LeshanDaFo/MeatLoaf-Hardware-ClausS/Hardware/README.md

# Meatloaf-Hardware-ClausS — Hardware

This directory contains the hardware designs and production documentation for
the Meatloaf carrier-board revisions published in this repository.

## Directory structure

```text
Hardware/
├── PCB-v1.0/
│   ├── README.md     # Revision-specific compatibility, placement, and GPIO information
│   ├── 3D/           # Complete mechanical STEP assembly
│   ├── Images/       # PCB plots, assembly drawing, and 3D renders
│   ├── KiCad/        # Editable KiCad project, schematics, and PCB layout
│   ├── PDF/          # PDF documentation, including schematic exports
│   └── Production/   # PCB manufacturing and assembly files, including Gerbers and BOMs
├── PCB-v1.1a/
├── PCB-v1.1b/
├── PCB-v1.1c/
│   ├── README.md     # Revision-specific design and validation status
│   ├── 3D/           # Complete mechanical STEP assembly
│   ├── Images/       # Verified KiCad rendering
│   ├── KiCad/        # Editable KiCad project and local dependencies
│   ├── PDF/          # Relevant component documentation
│   └── Production/   # Revision-specific manufacturing export
└── README.md
```

## Published hardware revisions

| Revision | Status | Documentation | Design and production files |
| --- | --- | --- | --- |
| PCB v1.0 | Published | [Compatibility, assembly, and GPIO assignments](PCB-v1.0/README.md) | [KiCad](PCB-v1.0/KiCad/) · [Schematic PDF](PCB-v1.0/PDF/Meatloaf-PCB-v1.0-Schematic.pdf) · [Production](PCB-v1.0/Production/) · [3D](PCB-v1.0/3D/) · [Images](PCB-v1.0/Images/) |
| PCB v1.1a | Discrete IEC input stages | [Design and firmware](PCB-v1.1a/README.md) | [KiCad](PCB-v1.1a/KiCad/) · [3D assembly](PCB-v1.1a/3D/Meatloaf-PCB-v1.1a-Assembly.step) · [Production](PCB-v1.1a/Production/) · [Images](PCB-v1.1a/Images/) |
| PCB v1.1b | 74LVC541A IEC input buffer | [Design, GPIO assignments, and validation status](PCB-v1.1b/README.md) | [KiCad](PCB-v1.1b/KiCad/) · [3D assembly](PCB-v1.1b/3D/Meatloaf-PCB-v1.1b-Assembly.step) · [Production](PCB-v1.1b/Production/) · [Images](PCB-v1.1b/Images/) |
| PCB v1.1c | USB-C power input and plug-in W5500 module | [Design and firmware](PCB-v1.1c/README.md) | [KiCad](PCB-v1.1c/KiCad/) · [3D assembly](PCB-v1.1c/3D/Meatloaf-PCB-v1.1c-Assembly.step) · [Production](PCB-v1.1c/Production/) · [Images](PCB-v1.1c/Images/) |

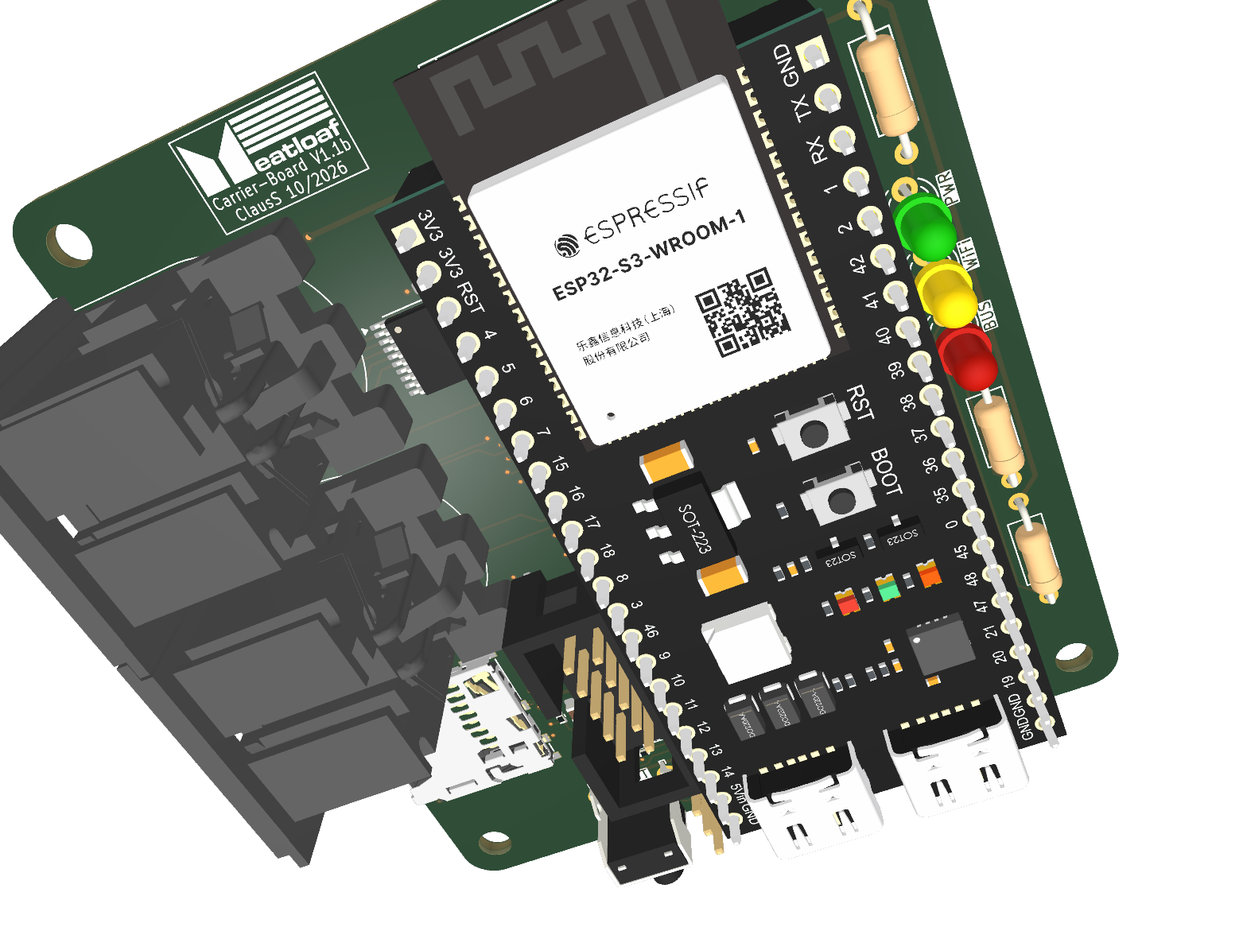
[picture p7: Hardware/PCB-v1.1b/Images/PCB-v1.1b-KiCad-3D.png]
Meatloaf PCB v1.1b development design


*KiCad rendering of the revised PCB v1.1b with the RGB level shifter.*

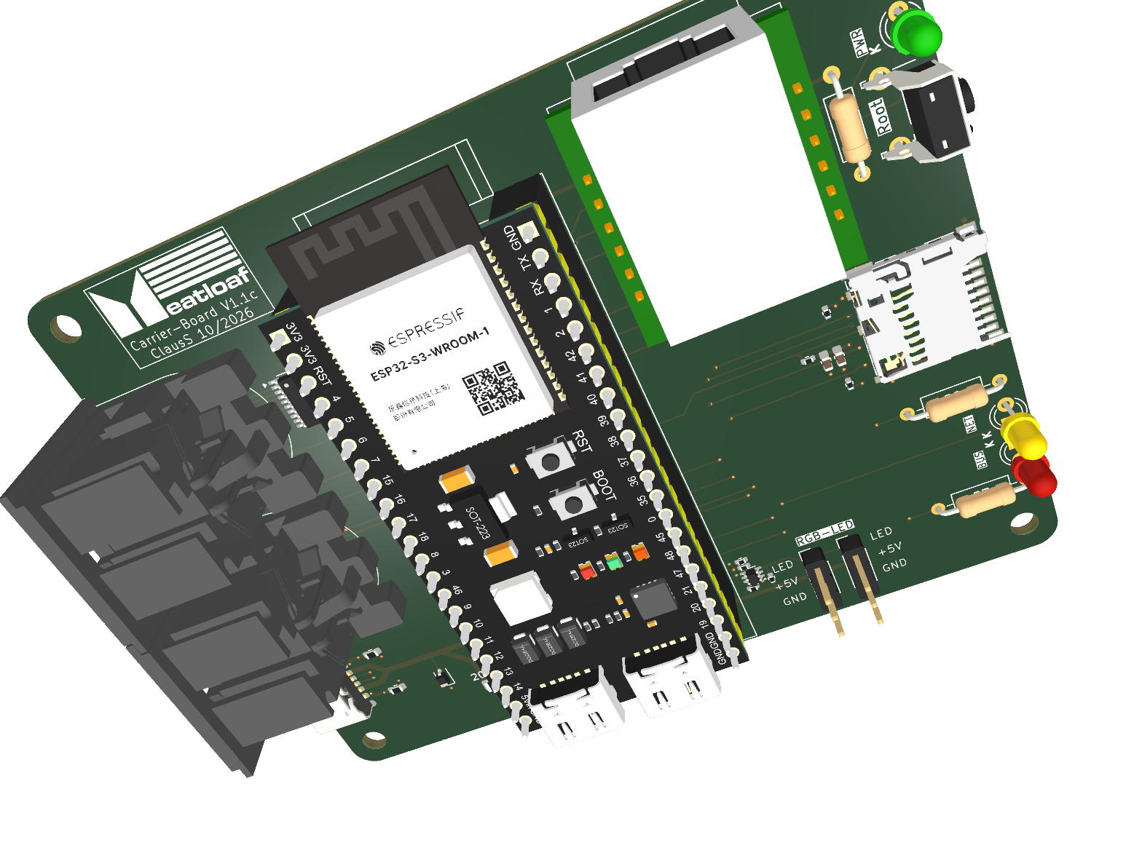
[picture p8: Hardware/PCB-v1.1c/Images/PCB-v1.1c-KiCad-3D-perspective.png]
Meatloaf PCB v1.1c


Each revision directory is self-contained and normally uses the following
structure:

- **`3D/`** contains mechanical STEP exports where provided.
- **`Images/`** contains PCB plots, assembly drawings, and rendered 3D views.
- **`KiCad/`** contains the editable hardware design. Open the project in KiCad to inspect the schematic and PCB layout.
- **`PDF/`** contains exported schematics and component documentation.
- **`Production/`** collects the manufacturing and assembly outputs for the
  revision, including Gerber and drill files, bills of materials (BOMs), and
  other production-related files where provided.

Future PCB revisions can be added as separate directories alongside
`PCB-v1.0/`, `PCB-v1.1a/`, `PCB-v1.1b/`, and `PCB-v1.1c/`. Do not mix documentation, design files, or
manufacturing outputs from different revisions.

## Hardware overview

The project provides custom **ESP32-based Meatloaf carrier boards**. Features,
module layouts, pin assignments, physical connections, and supported firmware
may differ between revisions. Use the documentation inside the selected
revision directory as the authoritative source for compatibility and assembly.

## Before manufacturing or assembly

1. Review the KiCad schematic and PCB layout for the selected revision.
2. Check the files in `Production/` and ensure that the Gerbers, drill files, BOM, and assembly information belong to the same PCB revision.
3. Verify connector orientation, component footprints, supply voltages, and IEC interface wiring.
4. Review any revision-specific notes and confirm the compatibility of the ESP32-S3 module you intend to use.
5. Check the applicable rights and licenses before redistributing third-party libraries, footprints, or 3D models.

## Firmware

Prebuilt firmware packages and installation information are provided separately
in [`Firmware/`](../Firmware/README.md). Select a package that matches the
hardware revision, GPIO configuration, flash capacity, and any other documented
requirements.

## License

The project's original hardware design materials are subject to the terms in [`LICENSE.md`](../LICENSE.md). A German-language version is available in [`LIZENZ.md`](../LIZENZ.md). Third-party files may be governed by separate licenses or usage restrictions.

This project uses a custom non-commercial hardware license; it is **not** an OSHWA-compliant open-source hardware license.
