LeshanDaFo/MeatLoaf-Hardware-ClausS/LIZENZ.md

# Meatloaf-Hardware-ClausS
## Nichtkommerzielle Hardwarelizenz und Rechtehinweis - Version 1.0

Copyright © 2026 Claus Schlereth

Diese deutsche Fassung ist verbindlich. Die englische Fassung in `LICENSE.md` dient als Übersetzung. Bei Abweichungen ist diese deutsche Fassung maßgeblich.

### 1. Begriffsbestimmungen

**Lizenzgeber** ist Claus Schlereth, im Projekt auch unter der Bezeichnung "ClausS" auftretend, als Urheber der eigenen Projektmaterialien.

**Eigene Projektmaterialien** sind diejenigen Schaltplan-, Leiterplatten-, Fertigungs-, Mechanik- und Dokumentationsdateien des Projekts Meatloaf-Hardware-ClausS, die vom Lizenzgeber erstellt wurden, rechtlich von ihm kontrolliert werden und keinen abweichenden Urheber- oder Lizenzhinweis tragen.

**Fremdmaterialien** sind sämtliche Dateien, Modelle, Bibliotheken, Symbole, Footprints, Bauteildaten, Software, Firmware, Marken und sonstigen Inhalte, die von Dritten erstellt oder kontrolliert werden.

**Kommerzielle Nutzung** ist eine Nutzung, die hauptsächlich auf einen geschäftlichen Vorteil oder eine finanzielle Vergütung gerichtet ist. Dazu gehören insbesondere Herstellung zum Verkauf oder zur Vermietung, Verwendung in einem kostenpflichtigen Produkt oder Dienst, entgeltliche Weitergabe, kommerzielle Vermarktung und Auftragsfertigung zum Weiterverkauf. Die Rechtsform des Nutzers allein entscheidet nicht darüber, ob eine Nutzung kommerziell ist.

**Selbstkosten** sind nachweisbare, einer zulässigen Sammelbestellung unmittelbar zurechenbare Aufwendungen gemäß Abschnitt 4.

### 2. Gegenstand und Rechteinhaberschaft

Diese Lizenz gilt ausschließlich für die eigenen Projektmaterialien.

Zu den eigenen Projektmaterialien können gehören:

- KiCad-Schaltpläne und Leiterplattenlayouts
- Gerber-Dateien, Bohrdaten und sonstige Fertigungsunterlagen
- Stücklisten und Bestückungsunterlagen
- Eigene, vom Lizenzgeber erstellte 3D-Modelle und mechanische Konstruktionen
- Zugehörige eigene Hardwaredokumentation

Fremdmaterialien werden von dieser Lizenz nicht erfasst, auch wenn sie in diesem Repository gespeichert, von einer Projektdatei referenziert, in einen Export eingebettet oder in einem Renderbild sichtbar sind. An Fremdmaterialien wird keine Rechteinhaberschaft beansprucht.

### 3. Nichtkommerzielle Rechtseinräumung

Vorbehaltlich der Bedingungen dieser Lizenz räumt der Lizenzgeber weltweit, unentgeltlich, nicht ausschließlich und für die Dauer der von ihm kontrollierten Rechte folgende Befugnisse ein:

a) Die eigenen Projektmaterialien für nichtkommerzielle Zwecke herunterzuladen, zu vervielfältigen, zu untersuchen und zu verwenden.

b) Die eigenen Projektmaterialien für nichtkommerzielle Zwecke zu ändern, zu verbessern und weiterzuentwickeln.

c) Die eigenen Projektmaterialien und zulässige Änderungen für nichtkommerzielle Zwecke zu veröffentlichen und weiterzugeben.

d) Hardware auf Grundlage der eigenen Projektmaterialien für private, schulische, wissenschaftliche, gemeinschaftliche oder sonstige nichtkommerzielle Zwecke herzustellen und zu verwenden.

e) Einen gewerblichen Leiterplattenhersteller, Bestückungsdienstleister oder anderen Dienstleister ausschließlich für eine nach dieser Lizenz zulässige Herstellung zu beauftragen.

Eingeräumt werden nur Urheber-, Design- und vergleichbare Rechte, die der Lizenzgeber besitzt oder einräumen darf. Patent-, Marken-, Namens- oder Rechte Dritter werden nicht eingeräumt, sofern dies nicht ausdrücklich schriftlich erklärt wird.

### 4. Sammelbestellungen und Weitergabe zu Selbstkosten

Nichtkommerzielle Sammelbestellungen von unbestückten Leiterplatten, elektronischen Bausätzen und bestückter Hardware sind zulässig.

Die Weitergabe muss zu Selbstkosten und ohne beabsichtigten Gewinn erfolgen. Zu den Selbstkosten dürfen nachweisbare Aufwendungen gehören für:

- Leiterplattenfertigung und unvermeidbare Einrichtungskosten der Fertigung
- Elektronische und mechanische Bauteile
- Professionelle Bestückung und Fertigungsdienstleistungen
- Prototypen, Prüfmuster und unvermeidbare Fehlexemplare, die der Sammelbestellung angemessen zugerechnet werden können
- Versand, Verpackung, Steuern, Zoll, Währungsumrechnung und notwendige Zahlungsgebühren

Die Kosten dürfen sachgerecht auf die Teilnehmer verteilt werden. Eine angemessene Abrechnungsrundung ist zulässig, wenn sie nicht der Gewinnerzielung dient. Wesentliche Überschüsse müssen erstattet, gutgeschrieben oder in der Endabrechnung ausgewiesen werden.

Vergütungen, Gewinnmargen, kommerzielle Aufschläge und ein dauerhafter kommerzieller Vertrieb sind nach diesem Abschnitt nicht zulässig. Dafür ist eine gesonderte schriftliche kommerzielle Genehmigung erforderlich.

### 5. Nicht eingeräumte Nutzungen

Ohne vorherige ausdrückliche schriftliche Genehmigung des Lizenzgebers gestattet diese Lizenz insbesondere nicht:

a) Die gewinnorientierte Herstellung, den Verkauf, die Vermietung oder die Weitergabe der Hardware.

b) Die kommerzielle Serienfertigung oder kommerzielle Vermarktung.

c) Die Einbindung der eigenen Projektmaterialien oder davon abgeleiteter Designs in ein kostenpflichtiges Produkt oder eine kostenpflichtige Dienstleistung.

d) Die Erhebung eines Entgelts für den Zugang zu den eigenen Projektmaterialien oder zulässigen Änderungen.

e) Die Unterlizenzierung erfasster Materialien unter Bedingungen, welche die nichtkommerziellen Beschränkungen oder die nach dieser Lizenz gewährten Empfängerrechte beseitigen.

Die entgeltliche Tätigkeit eines Fertigungsdienstleisters macht die ansonsten zulässige nichtkommerzielle Nutzung seines Auftraggebers nicht allein deshalb kommerziell.

### 6. Namensnennung und Kennzeichnung

Bei Veröffentlichung oder Weitergabe erfasster Materialien, Änderungen oder darauf beruhender Hardware müssen die folgenden Angaben in den Dateien erhalten bleiben oder in Begleitdokumentation, Verpackung oder über einen dauerhaften Projektlink angemessen zugänglich gemacht werden:

- Projektname: Meatloaf-Hardware-ClausS
- Urheberhinweis: Copyright © 2026 Claus Schlereth
- Ursprüngliches Repository: https://github.com/LeshanDaFo/Meatloaf-Hardware-ClausS
- Hinweis oder Link auf diese Lizenz

Veränderte Fassungen müssen eindeutig als verändert gekennzeichnet werden. Es darf nicht behauptet oder der Eindruck erweckt werden, dass sie vom Lizenzgeber geprüft, freigegeben, hergestellt, gewährleistet oder empfohlen wurden.

### 7. Änderungen und Weitergabe

Bei Weitergabe veränderter eigener Projektmaterialien gilt:

a) Die geänderten Designunterlagen müssen in der bevorzugten bearbeitbaren Form bereitgestellt werden, die für die Änderungen verwendet wurde.

b) Ursprünglicher Urheber, Repository, Urheberhinweis und diese Lizenz müssen angegeben werden.

c) Wesentliche Änderungen und ihr Datum müssen in angemessener Weise dokumentiert werden.

d) Von den eigenen Projektmaterialien abgeleitete Bestandteile müssen bei Weitergabe unter dieser Lizenz bleiben.

Unabhängig entwickelte Bestandteile und bloße Zusammenstellungen werden dadurch nicht automatisch von dieser Lizenz erfasst.

### 8. Fremdmaterialien, 3D-Modelle und Renderbilder

Fremdmaterialien unterliegen ausschließlich den Rechten, Hinweisen, Lizenzen und Beschränkungen ihrer jeweiligen Rechteinhaber. Diese Lizenz unterlizenziert, ersetzt oder verändert diese Bedingungen nicht.

Soweit die jeweils geltenden Fremdbedingungen dies erlauben, dürfen fremde 3D-Modelle vom KiCad-Projekt referenziert und in Renderbildern ausschließlich zur Veranschaulichung, Dokumentation, Kompatibilitätserklärung und bildlichen Darstellung des Gesamtprojekts gezeigt werden. Der Lizenzgeber beansprucht nur Rechte an seinen eigenen Beiträgen zu solchen Bildern, soweit diese rechtlich geschützt sind. Diese Lizenz gewährt kein Recht, ein zugrunde liegendes fremdes Modell zu extrahieren, wiederzuverwenden, zur Fertigung zu benutzen oder weiterzugeben.

Ein STEP-, CAD- oder sonstiger Export, der Geometrie fremder Modelle enthält, wird als Gesamtdatei nicht ausschließlich unter dieser Lizenz bereitgestellt. Die vom Lizenzgeber selbst erstellten Bestandteile bleiben im Umfang der von ihm kontrollierten Rechte von dieser Lizenz erfasst. Für enthaltene Fremdmaterialien gelten unabhängig davon ausschließlich die jeweiligen Rechte, Lizenzen und Nutzungsbedingungen. Die Nutzung oder Weitergabe eines solchen Exports ist nur zulässig, soweit jede einschlägige Fremdlizenz oder Genehmigung die betreffende Nutzung beziehungsweise Weitergabe der darin enthaltenen fremden Geometrie unabhängig erlaubt.

Soweit bekannt, werden Urheber, Herkunft und vorhandene Lizenzhinweise verwendeter Fremdmaterialien in der Projektdokumentation genannt. Verpflichtende Namensnennungen, Lizenzhinweise und sonstige Informationspflichten aus den jeweils anwendbaren Fremdbedingungen bleiben unberührt und müssen unabhängig davon vollständig erfüllt werden. Solche Angaben dienen der Transparenz; sie übertragen keine Nutzungsrechte und bestätigen nicht, dass eine bestimmte Verwendung vom jeweiligen Rechteinhaber genehmigt wurde.

Die Darstellung fremder Namen, Logos, Produkterscheinungen oder Modelle begründet keine Verbindung, Unterstützung, Freigabe oder Übertragung von Markenrechten.

Wird ein nachvollziehbarer Rechtehinweis gemeldet, darf der Lizenzgeber das betroffene Material entfernen, ersetzen oder dessen Nutzung einschränken, ohne damit eine Haftung oder Rechtsverletzung anzuerkennen.

### 9. Keine Gewähr für Rechte an Fremdmaterialien

Der Lizenzgeber räumt ausschließlich Rechte ein, über die er rechtlich verfügen darf. Es wird nicht zugesichert, dass jedes referenzierte oder bereitgestellte Fremdmaterial für einen bestimmten Zweck geeignet ist oder nach dieser Lizenz weitergegeben werden darf.

Nutzer sind selbst dafür verantwortlich, vor dem Kopieren, Weitergeben, Fertigen oder kommerziellen Verwenden von Fremdmaterialien oder diese enthaltenden Exporten sämtliche einschlägigen Hinweise und Lizenzen zu prüfen und einzuhalten.

### 10. Gewährleistungs- und Haftungsausschluss

Die eigenen Projektmaterialien und daraus entstehende Hardware werden im gesetzlich größtmöglichen Umfang **"WIE BESEHEN"** und ohne Gewähr für Funktion, Zuverlässigkeit, Richtigkeit, elektrische Sicherheit, Eignung für einen bestimmten Zweck, Freiheit von Rechten Dritter oder Einhaltung gesetzlicher Anforderungen bereitgestellt.

Nachbau, Änderung und Betrieb erfolgen auf eigene Gefahr. Der Lizenzgeber haftet für Schäden aus der Verwendung der Materialien oder Hardware nur, soweit ein Haftungsausschluss gesetzlich nicht zulässig ist.

Unberührt bleibt insbesondere eine gesetzlich zwingende Haftung wegen Vorsatz, grober Fahrlässigkeit, Verletzung von Leben, Körper oder Gesundheit sowie nach anwendbarem Produkthaftungsrecht.

### 11. Beendigung und Heilung

Die Rechte aus dieser Lizenz enden automatisch für eine Person, die wesentlich gegen ihre Bedingungen verstößt.

Bei einem erstmaligen unbeabsichtigten Verstoß leben die Rechte vorläufig wieder auf, wenn der Verstoß innerhalb von 30 Tagen nach eigener Kenntnis oder schriftlichem Hinweis vollständig beseitigt wird. Wiederholte, vorsätzliche oder nicht fristgerecht beseitigte Verstöße erfordern eine schriftliche Wiedereinsetzung durch den Lizenzgeber.

Die Beendigung berührt keine zuvor wirksam von einem lizenzkonformen Weitergeber an andere Empfänger eingeräumten Rechte.

### 12. Durchsetzung und kein Rechtsverzicht

Der Lizenzgeber ist nicht verpflichtet, jeden Verstoß zu untersuchen oder zu verfolgen. Eine verzögerte oder unterlassene Durchsetzung bedeutet keinen Verzicht auf eine Bestimmung oder ein Recht. Ein Verzicht ist nur wirksam, wenn er für den konkreten Fall ausdrücklich schriftlich erklärt wird.

### 13. Gesonderte kommerzielle Genehmigung

Eine kommerzielle Nutzung kann durch eine gesonderte schriftliche Vereinbarung mit dem Lizenzgeber gestattet werden. Eine solche Genehmigung gilt ausschließlich für die darin ausdrücklich bezeichneten Tätigkeiten, Materialien, Personen und Zeiträume.

### 14. Schlussbestimmungen

Diese Lizenz räumt nur die ausdrücklich genannten Rechte ein. Alle übrigen Rechte verbleiben bei ihren jeweiligen Rechteinhabern.

Sollte eine Bestimmung unwirksam oder nicht durchsetzbar sein, bleiben die übrigen Bestimmungen im gesetzlich zulässigen Umfang wirksam.

Soweit eine Rechtswahl zulässig ist, gilt das Recht der Bundesrepublik Deutschland unter Ausschluss seiner Kollisionsnormen und des Übereinkommens der Vereinten Nationen über Verträge über den internationalen Warenkauf.

Der Lizenzgeber darf für zukünftige Veröffentlichungen überarbeitete Lizenzfassungen herausgeben. Bereits unter dieser Version veröffentlichte Materialien werden dadurch nicht rückwirkend einer neuen Fassung unterstellt.

---

**Lizenzstatus:** Individuelle, nichtkommerzielle Hardwarelizenz. Sie ist wegen der Beschränkung kommerzieller Nutzung keine OSHWA-konforme Open-Source-Hardware-Lizenz.

**Version:** 1.0, gültig ab 21. Oktober 2026.
