LeshanDaFo/MeatLoaf-Hardware-ClausS/Hardware/PCB-v1.0/Images/PCB-Bottom.png

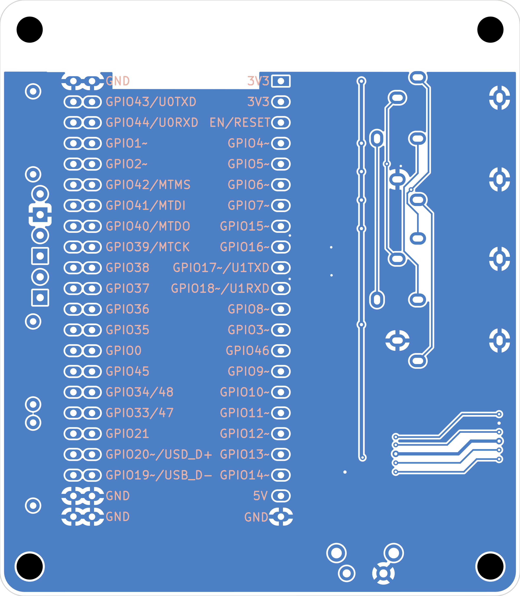
Hardware/PCB-v1.0/Images/PCB-Bottom.png
