LeshanDaFo/MeatLoaf-Hardware-ClausS/Hardware/PCB-v1.1a/Images/PCB-v1.1a-KiCad-3D.png

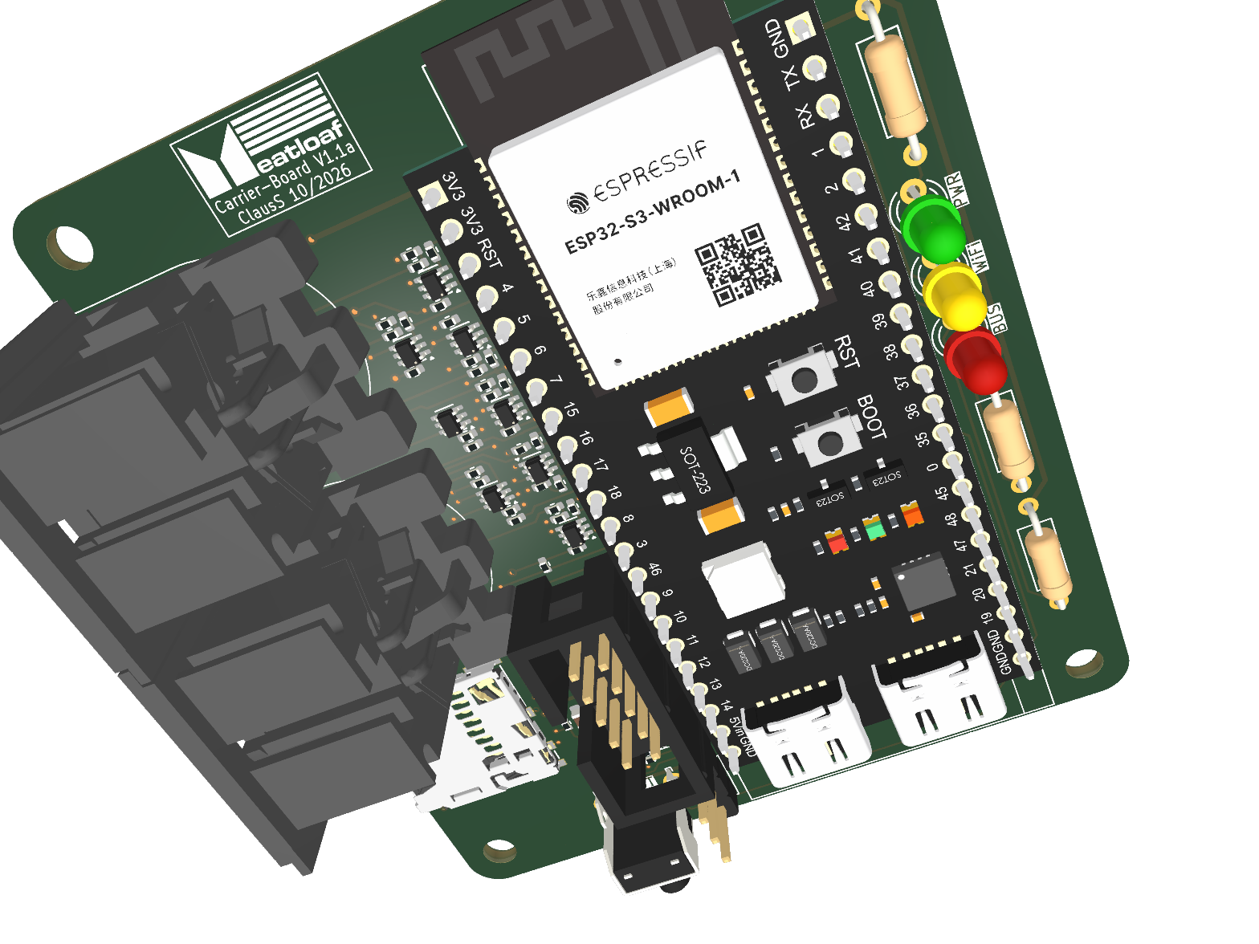
Hardware/PCB-v1.1a/Images/PCB-v1.1a-KiCad-3D.png
