LeshanDaFo/MeatLoaf-Hardware-ClausS/Hardware/PCB-v1.1b/Production/bom.csv

Designator | Footprint | Quantity | Value | LCSC Part #
C1 | 0603 | 1 | 10uF
C2, C3 | 0603 | 2 | 100nF
J3 | MOLEX_503398-1892 | 1 | 503398-1892 | C428492
Q6, Q7, Q8, Q9 | SOT-363_SC-70-6 | 4 | BC847BS
R20, R31, R32, R35 | 0402 | 4 | 1k5
R21, R22, R25, R26, R33, R34, R36, R38, R39, R40 | 0402 | 10 | 10k
R23 | 0402 | 1 | 1k
R24, R37 | 0402 | 2 | 2k2
U2 | TSSOP-20_4.4x6.5mm_P0.65mm | 1 | 74LVC541A
