LeshanDaFo/MeatLoaf-Hardware-ClausS/Hardware/PCB-v1.1c/Production/bom.csv

Designator | Footprint | Quantity | Value | LCSC Part #
C1, C3 | 0603 | 2 | 100nF
C2 | 0603 | 1 | 10uF
F1 | 1206 | 1 | 20V/2A
J5 | MOLEX_503398-1892 | 1 | 503398-1892 | C428492
P1 | USB_C_Receptacle_GCT_USB4125-xx-x_6P_TopMnt_Horizontal | 1 | USB_C_Plug_USB2.0
Q1, Q2, Q3, Q4 | SOT-363_SC-70-6 | 4 | BC847BS
R1, R2 | 0603 | 2 | 5k1
R10, R12, R14, R19 | 0402 | 4 | 1k5
R11, R13, R15, R16, R17, R18, R20, R21, R4, R6 | 0402 | 10 | 10k
R22 | 0402 | 1 | 1k
R3, R5 | 0402 | 2 | 2k2
SW1 | SW_Tactile_SPST_Angled_PTS645Vx39-2LFS | 1 | Root
U1 | ESP32-S3-DevKitC-1 | 1 | ESP32-S3-DevKitC
U2 | TSSOP-20_4.4x6.5mm_P0.65mm | 1 | 74LVC541A
