LeshanDaFo/MeatLoaf-Hardware-ClausS/Hardware/PCB-v1.0/Production/bom.csv

Designator | Footprint | Quantity | Value | LCSC Part #
C1 | 0603 | 1 | 10uF
C2 | 0603 | 1 | 100nF
D1 | LED_D3.0mm | 1 | Power
D2 | LED_D3.0mm | 1 | WiFi
D3 | LED_D3.0mm | 1 | BUS
J1 | MOLEX_503398-1892 | 1 | 503398-1892 | C428492
J2, J3 | Commodore_IEC | 2 | Commodore IEC | 0105 06
Q1, Q2, Q3, Q4, Q5 | SOT-23 | 5 | 2N7002 | C8545
Q6, Q7 | SOT-23 | 2 | MMBT3904 | C20526
R1, R10, R2, R3, R4, R5 | 0603 | 6 | 10k
R11, R12, R13 | R_Axial_DIN0207_L6.3mm_D2.5mm_P10.16mm_Horizontal | 3 | 470
R6, R8 | 0603 | 2 | 4k7
R7, R9 | 0603 | 2 | 100k
SW1 | SW_Tactile_SPST_Angled_PTS645Vx58-2LFS | 1 | ROOT
U1 | ESP32-S3-DevKitC-1 | 1 | ESP32-S3-DevKitC
