LeshanDaFo/MeatLoaf-Hardware-ClausS/Hardware/PCB-v1.1a/Production/bom.csv

Designator | Footprint | Quantity | Value | LCSC Part #
C1 | 0603 | 1 | 10uF
C2 | 0603 | 1 | 100nF
J3 | MOLEX_503398-1892 | 1 | 503398-1892 | C428492
Q1, Q2, Q3, Q4, Q5, Q6, Q7, Q8, Q9 | SOT-363_SC-70-6 | 9 | BC847BS
R1, R10, R14, R15, R16, R17, R18, R19, R2, R27, R28, R29, R3, R30, R4, R5, R6, R7, R8, R9 | 0402 | 20 | 5k1
R20, R31, R32, R35 | 0402 | 4 | 1k5
R21, R22, R25, R26, R33, R34, R36, R38, R39, R40 | 0402 | 10 | 10k
R23 | 0402 | 1 | 1k
R24, R37 | 0402 | 2 | 2k2
