LeshanDaFo/MeatLoaf-Hardware-ClausS/Hardware/PCB-v1.1a/3D/Meatloaf-PCB-v1.1a-Assembly.step

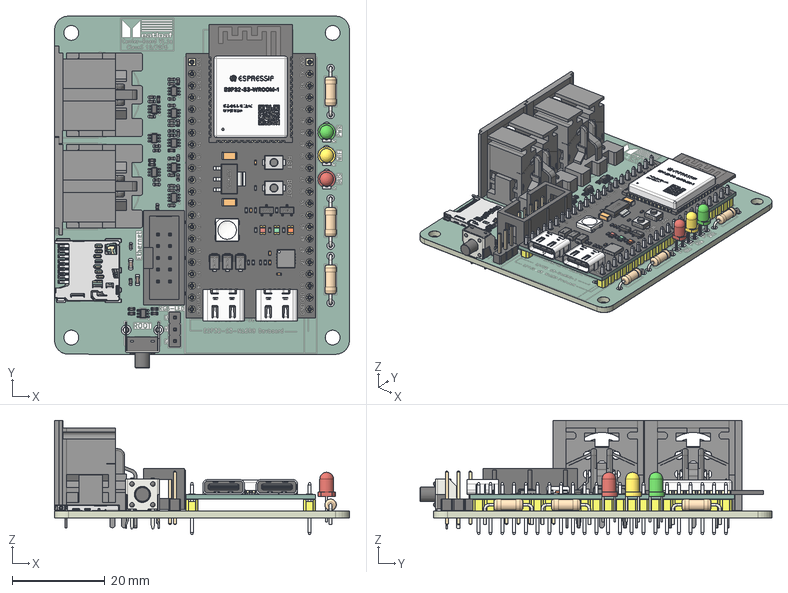
[picture p15: CAD file, 2026-11-14]
Hardware/PCB-v1.1a/3D/Meatloaf-PCB-v1.1a-Assembly.step
63.7 x 75.9 x 24.7 mm
R_0402_1005Metric x 37
SOT-363_SC-70-6 x 9
LED_D3.0mm x 3
IDC_Header_2x05_P254mm_Vertical
PCB
ESP-S3-WROOM_via v3 x 26
ESP32-S3-WROOM_shell v11
ESP32-S3-WROOM_body v12
ESP-S3-WROOM_via v3(镜像) x 14
USB Connector Type C female 6pin v3 x 2
DO220AA v1 x 3
WS2812B v1
Light x 3
Anode Bottom x 3
Cathode Bottom x 3
Anode x 3
Cathode x 3
Base x 3
SOT-223 v1
SOT-23 v1 x 2
3x4x2mm - 2 Pad v2 x 2
22way PCB Header x 2
C_0603_1608Metric x 2
R_Axial_DIN0207_L63mm_D25mm_P1016mm_Horizontal x 3
lumberg_0105_06 x 2
PinHeader_1x03_P254mm_Vertical
SW_Tactile_SPST_Angled_PTS645Vx58-2LFS
Meatloaf_copper
Meatloaf_pad
Meatloaf_via
Meatloaf_silkscreen x 2
Meatloaf_soldermask x 2
Meatloaf_PCB
