LeshanDaFo/MeatLoaf-Hardware-ClausS/Hardware/PCB-v1.1a/KiCad/3Dstep/503398-1892--3DModel-STEP-56544.STEP

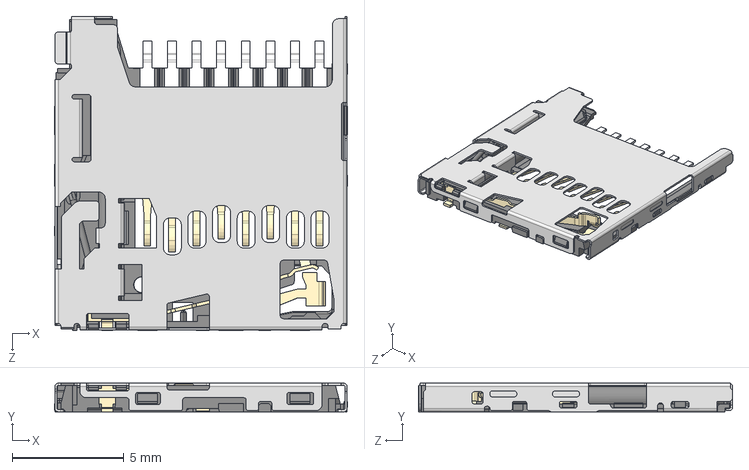
[picture p18: CAD file, 2026-11-12]
Hardware/PCB-v1.1a/KiCad/3Dstep/503398-1892--3DModel-STEP-56544.STEP
13.1 x 1.28 x 14.1 mm
