LeshanDaFo/MeatLoaf-Hardware-ClausS/Hardware/PCB-v1.0/Images/PCB-Top-Assembly.png

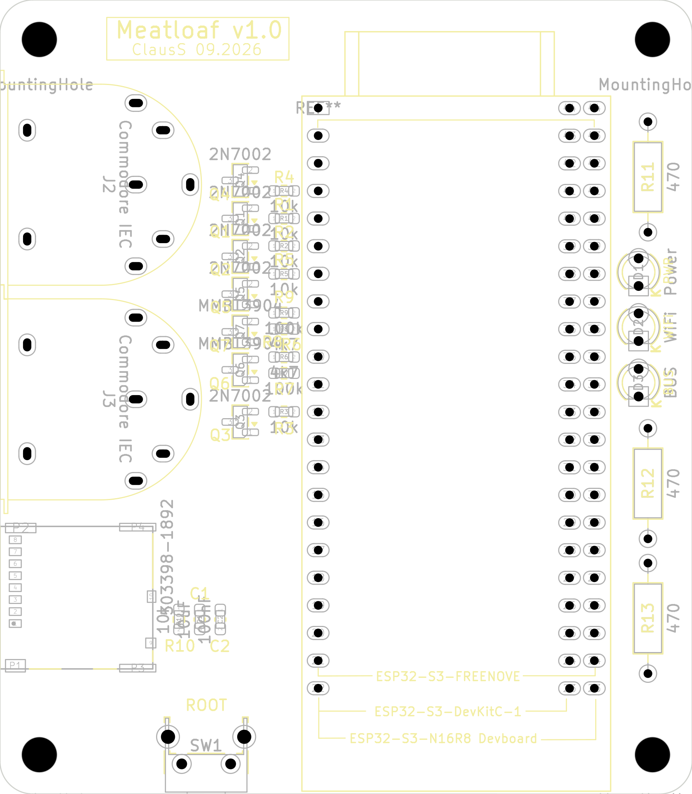
Hardware/PCB-v1.0/Images/PCB-Top-Assembly.png
