LeshanDaFo/MeatLoaf-Hardware-ClausS/Hardware/PCB-v1.0/PDF/Meatloaf-PCB-v1.0-Schematic.pdf

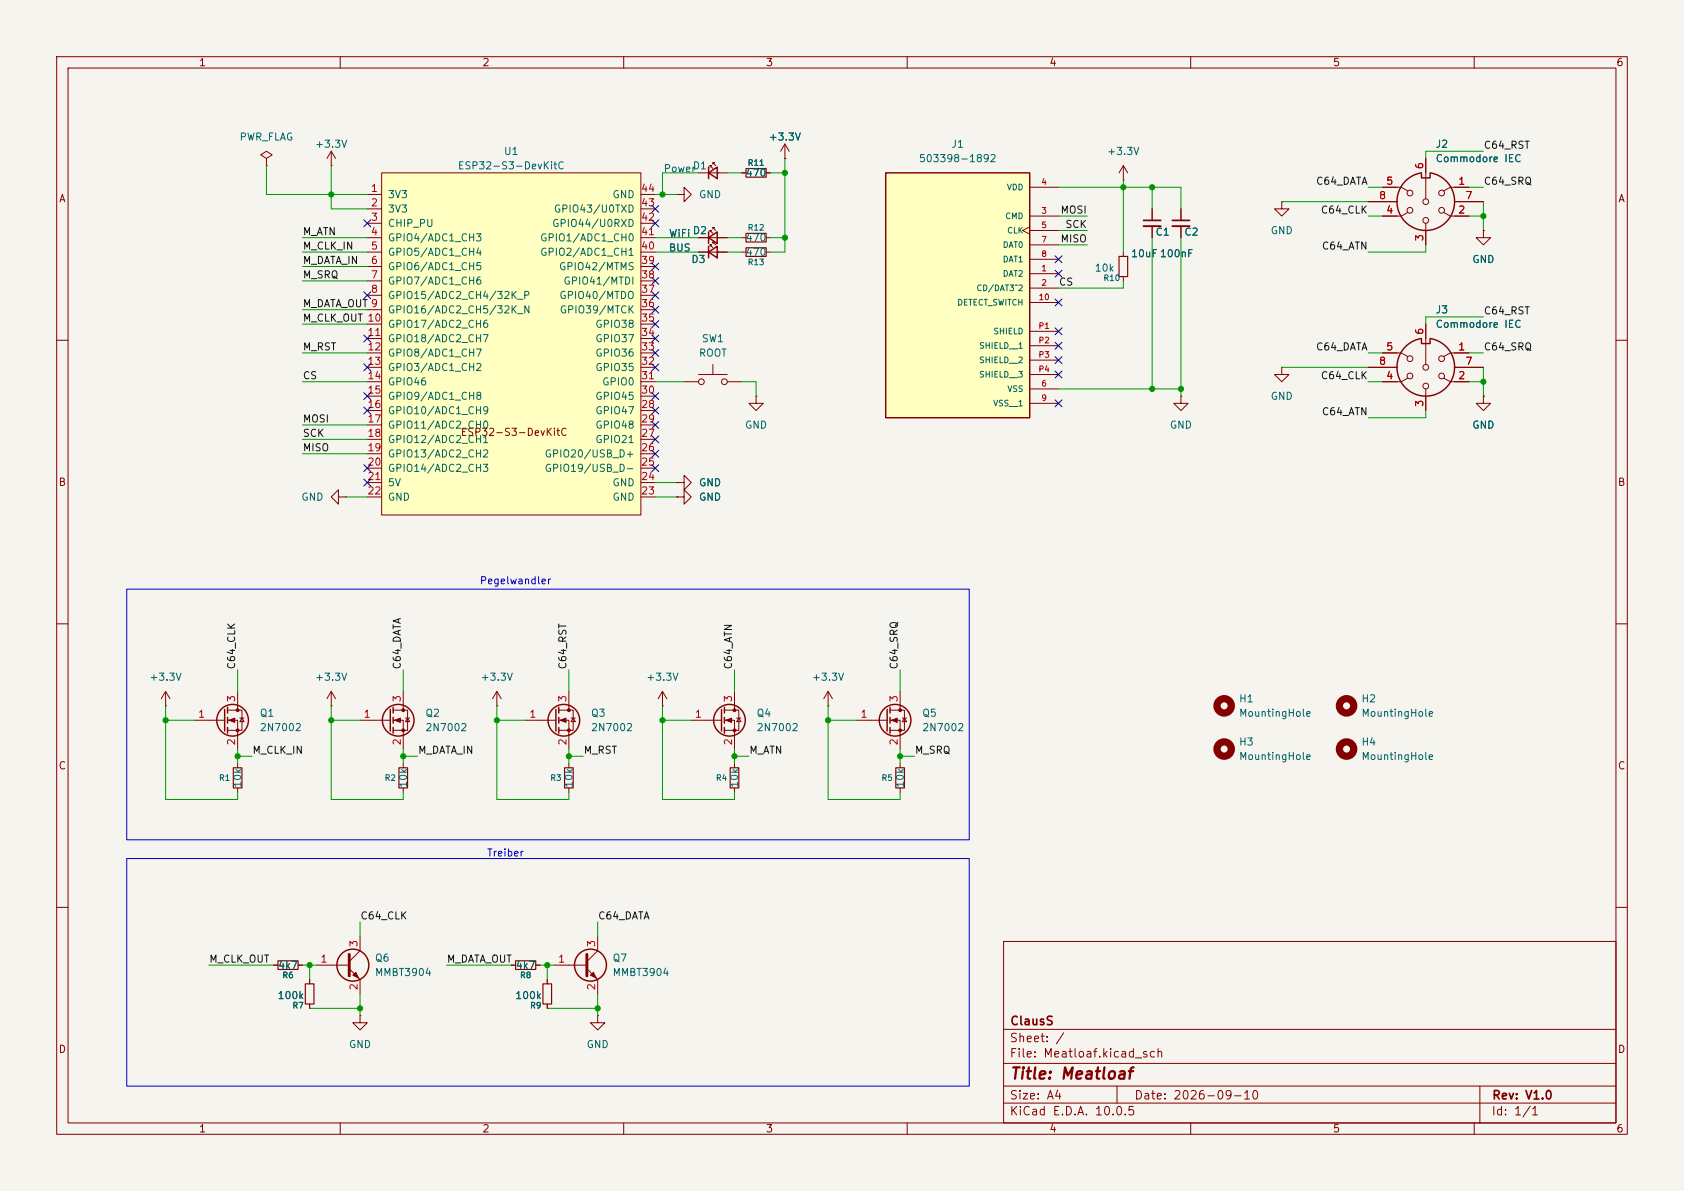
[picture p20: page 1]

R5 10k R4 10k GND C64_DATA

Size: A4 | Rev: V1.0
KiCad E.D.A. 10.0.5 | Id: 1/1
