LeshanDaFo/MeatLoaf-Hardware-ClausS/Hardware/PCB-v1.0/KiCad/Meatloaf.kicad_pcb

## KiCad design Hardware/PCB-v1.0/KiCad/Meatloaf.kicad_pcb (2026-11-14)

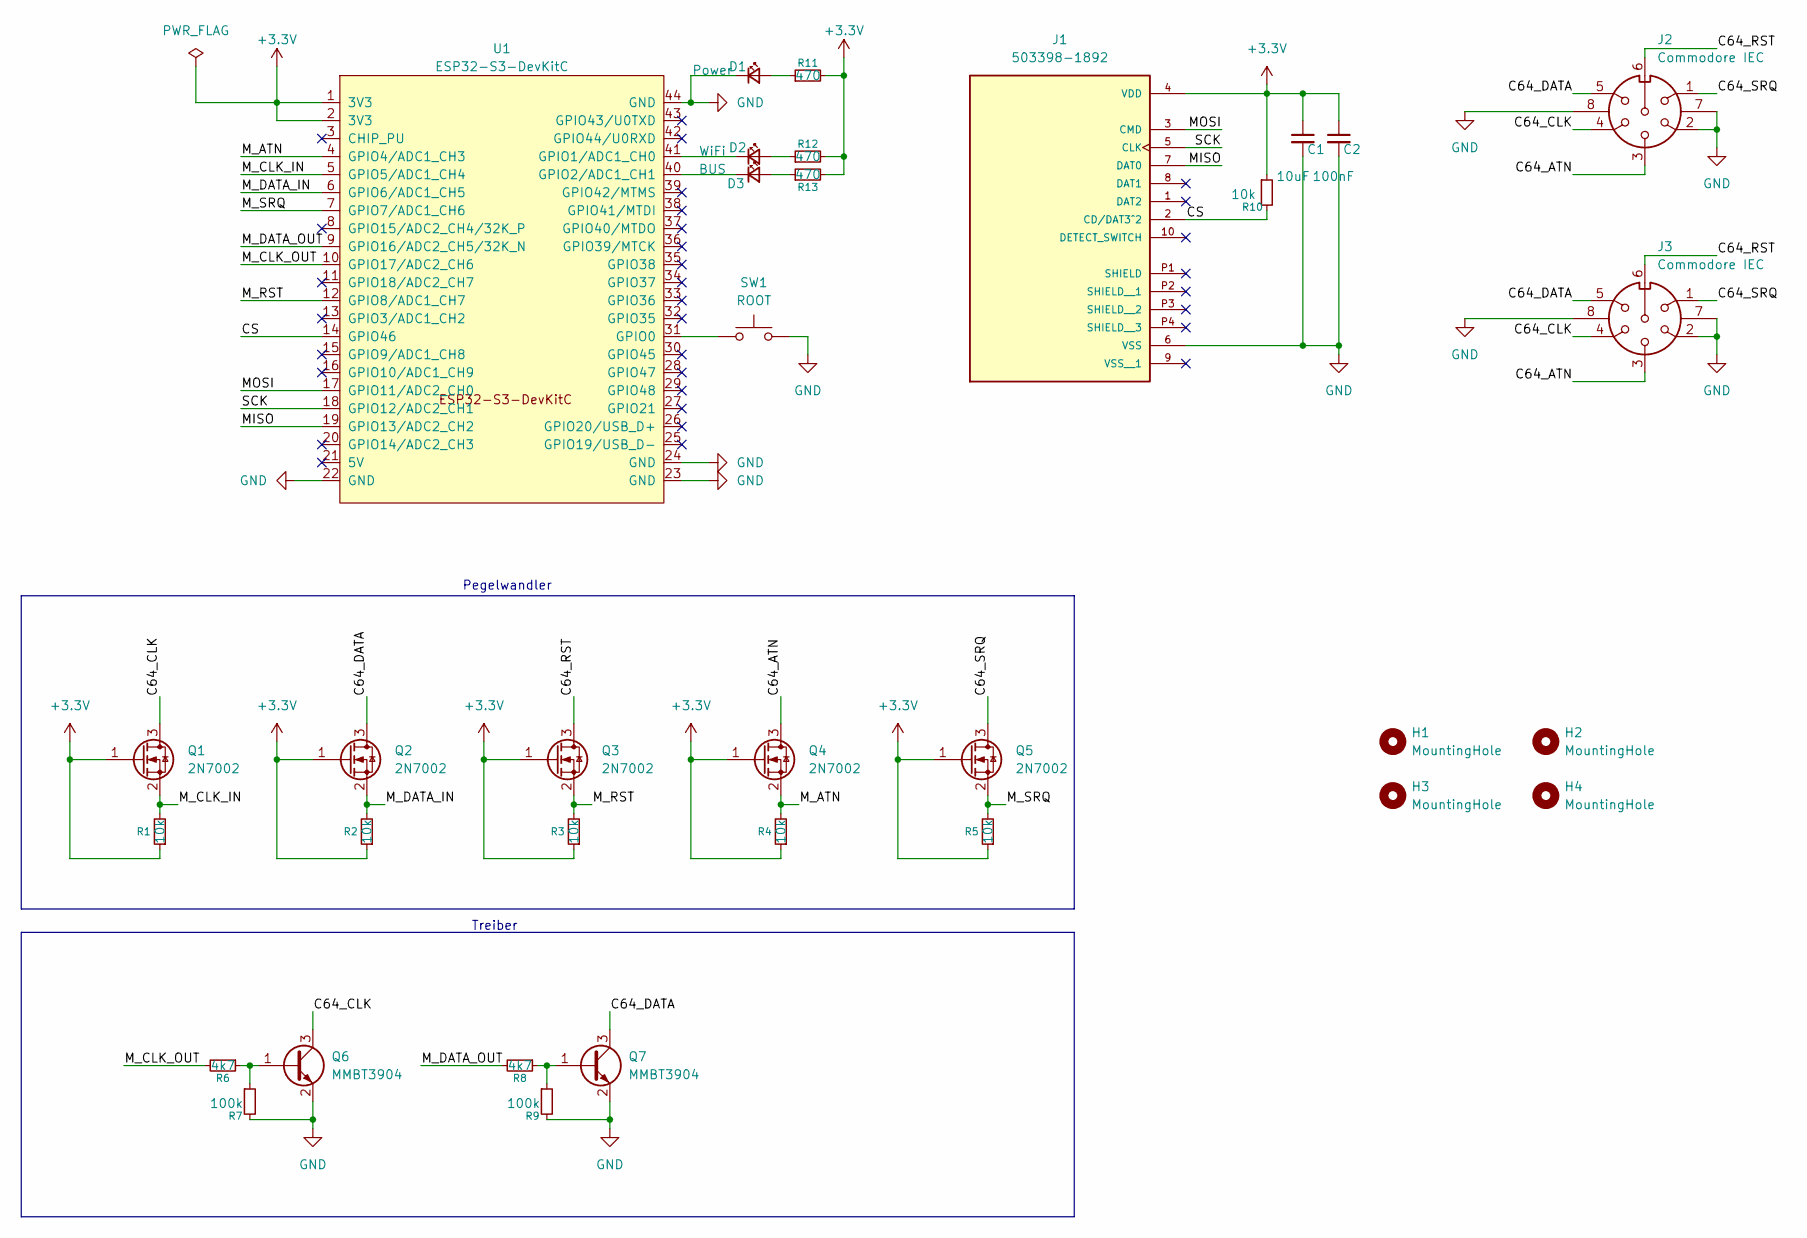
[picture p21: schematic Meatloaf.kicad_sch]

Parts:
C1: 10uF; C_0603_1608Metric_Pad1.08x0.95mm_HandSolder
C2: 100nF; C_0603_1608Metric_Pad1.08x0.95mm_HandSolder
D1: Power; LED_D3.0mm
D2: WiFi; LED_D3.0mm
D3: BUS; LED_D3.0mm
H1, H2, H3, H4: MountingHole; MountingHole_3.2mm_M3
J1: 503398-1892; MOLEX_503398-1892; PARTREV 0; LCSC Part # C428492
J2, J3: Commodore IEC; Commodore_IEC; MPN 0105 06
Q1, Q2, Q3, Q4, Q5: 2N7002; SOT-23; LCSC Part # C8545
Q6, Q7: MMBT3904; SOT-23; LCSC Part # C20526
R1, R2, R3, R4, R5, R10: 10k; R_0603_1608Metric_Pad0.98x0.95mm_HandSolder
R6, R8: 4k7; R_0603_1608Metric_Pad0.98x0.95mm_HandSolder
R7, R9: 100k; R_0603_1608Metric_Pad0.98x0.95mm_HandSolder
R11, R12, R13: 470; R_Axial_DIN0207_L6.3mm_D2.5mm_P10.16mm_Horizontal
SW1: ROOT; SW_Tactile_SPST_Angled_PTS645Vx58-2LFS
U1: ESP32-S3-DevKitC; ESP32-S3-DevKitC-1

Connections:
+3.3V: C1.1, C2.1, J1.4 (VDD), Q1.1 (G), Q2.1 (G), Q3.1 (G), Q4.1 (G), Q5.1 (G), R1.1, R2.1, R3.1, R4.1, R5.1, R10.1, R11.2, R12.2, R13.2, U1.1 (3V3), U1.2 (3V3)
/C64_ATN: J2.3, J3.3, Q4.3 (D)
/C64_CLK: J2.4, J3.4, Q1.3 (D), Q6.3 (C)
/C64_DATA: J2.5, J3.5, Q2.3 (D), Q7.3 (C)
/C64_RST: J2.6, J3.6, Q3.3 (D)
/C64_SRQ: J2.1, J3.1, Q5.3 (D)
/CS: J1.2 (CD/DAT3^2), R10.2, U1.14 (GPIO46)
/MISO: J1.7 (DAT0), U1.19 (GPIO13/ADC2_CH2)
/MOSI: J1.3 (CMD), U1.17 (GPIO11/ADC2_CH0)
/M_ATN: Q4.2 (S), R4.2, U1.4 (GPIO4/ADC1_CH3)
/M_CLK_IN: Q1.2 (S), R1.2, U1.5 (GPIO5/ADC1_CH4)
/M_CLK_OUT: R6.2, U1.10 (GPIO17/ADC2_CH6)
/M_DATA_IN: Q2.2 (S), R2.2, U1.6 (GPIO6/ADC1_CH5)
/M_DATA_OUT: R8.2, U1.9 (GPIO16/ADC2_CH5/32K_N)
/M_RST: Q3.2 (S), R3.2, U1.12 (GPIO8/ADC1_CH7)
/M_SRQ: Q5.2 (S), R5.2, U1.7 (GPIO7/ADC1_CH6)
/SCK: J1.5 (CLK), U1.18 (GPIO12/ADC2_CH1)
GND: C1.2, C2.2, D1.1 (K), J1.6 (VSS), J2.2, J2.7, J2.8, J3.2, J3.7, J3.8, Q6.2 (E), Q7.2 (E), R7.2, R9.2, SW1.2, U1.22 (GND), U1.23 (GND), U1.24 (GND), U1.44 (GND)
unnamed: D1.2 (A), R11.1
unnamed: D2.2 (A), R12.1
unnamed: D2.1 (K), U1.41 (GPIO1/ADC1_CH0)
unnamed: D3.2 (A), R13.1
unnamed: D3.1 (K), U1.40 (GPIO2/ADC1_CH1)
unnamed: Q6.1 (B), R6.1, R7.1
unnamed: Q7.1 (B), R8.1, R9.1
unnamed: SW1.1, U1.31 (GPIO0)

Notes on the sheet:
Pegelwandler
Treiber

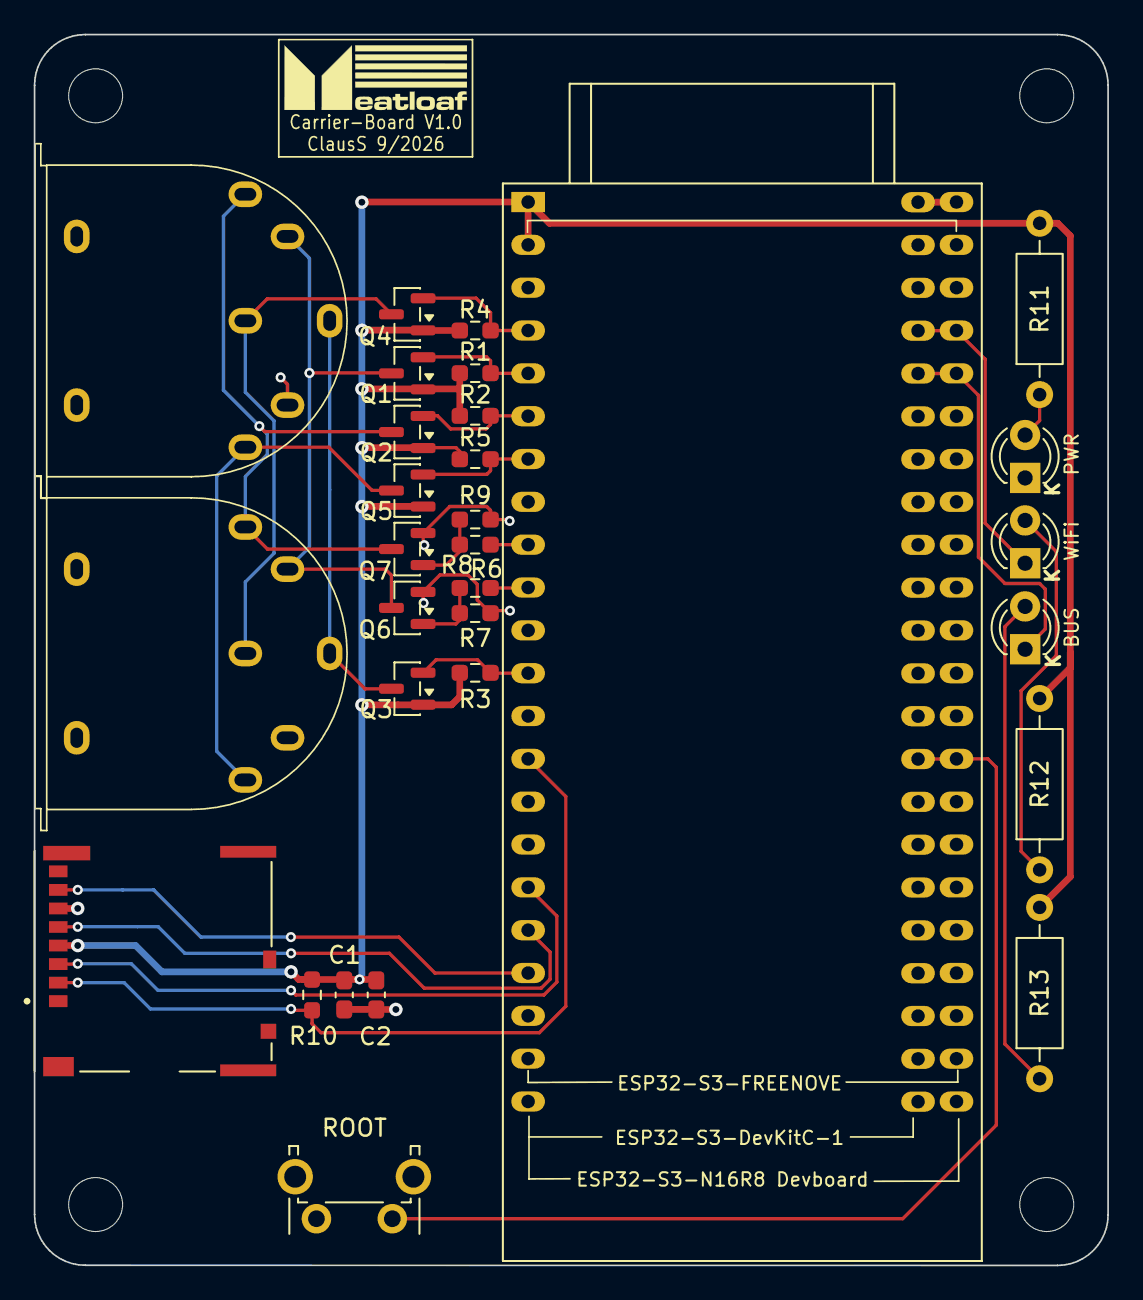
[picture p22: board Hardware/PCB-v1.0/KiCad/Meatloaf.kicad_pcb from above]

Board: 2 copper layers, 63.7 x 73.0 mm, 34 parts (0 on the bottom side), 26 nets.
