LeshanDaFo/MeatLoaf-Hardware-ClausS/Hardware/PCB-v1.1c/KiCad/Meatloaf.kicad_pcb

## KiCad design Hardware/PCB-v1.1c/KiCad/Meatloaf.kicad_pcb (2026-11-14)

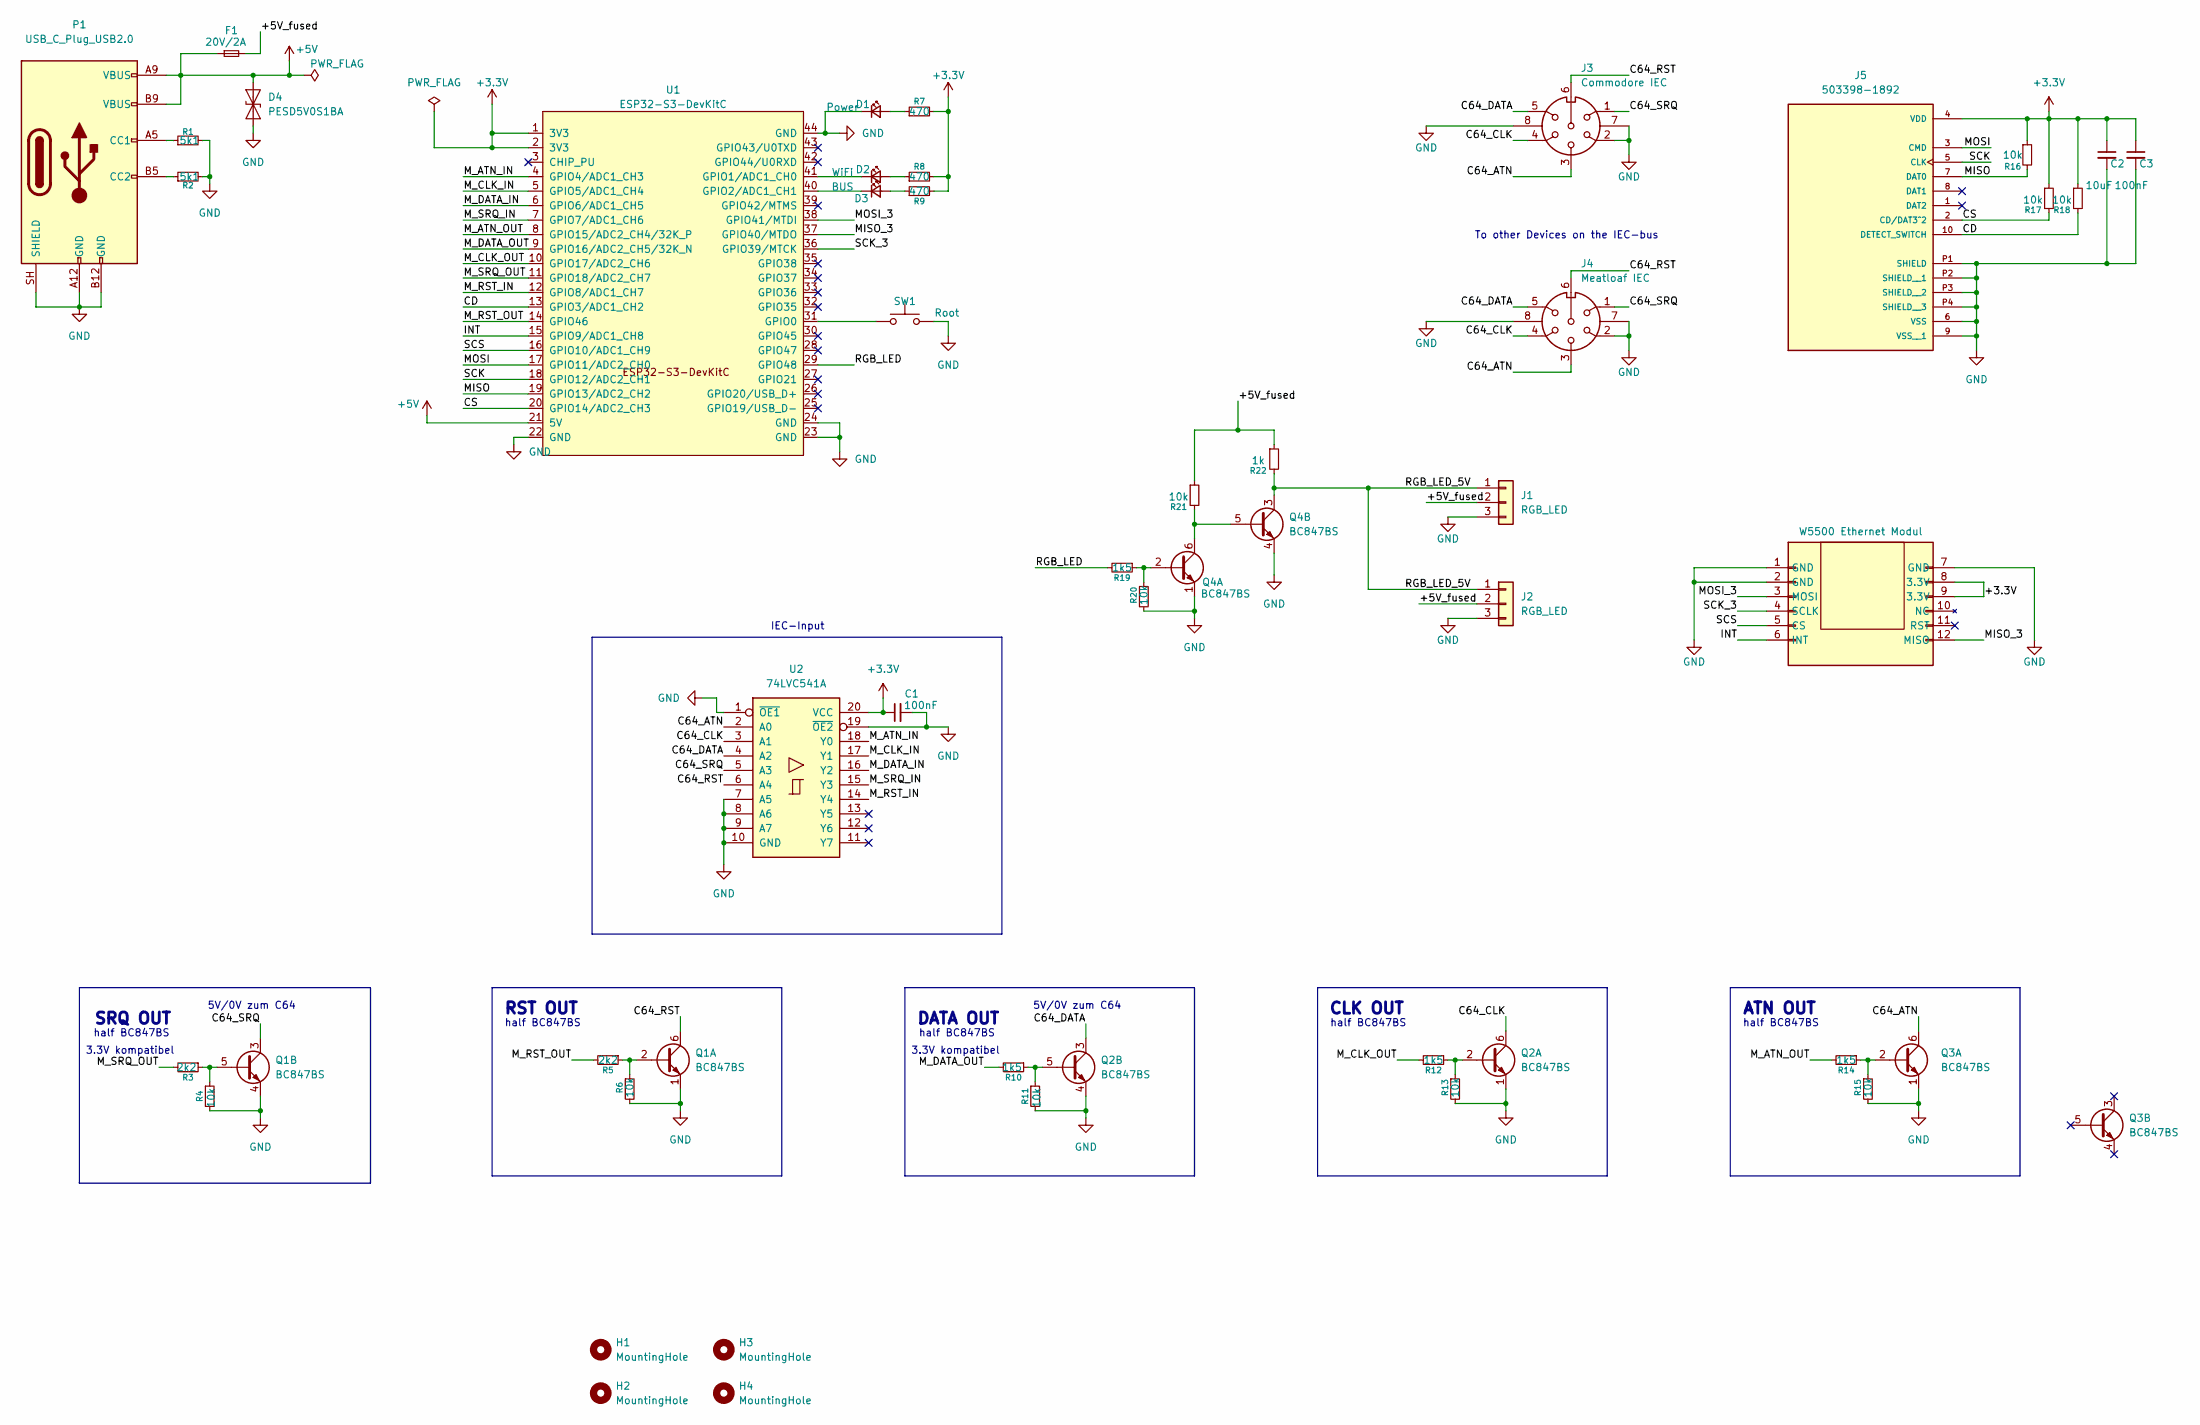
[picture p23: schematic Meatloaf.kicad_sch, Meatloaf Carrier Board]

Parts:
C1: 100nF; C_0603_1608Metric_Pad1.08x0.95mm_HandSolder
C2: 10uF; C_0603_1608Metric
C3: 100nF; C_0603_1608Metric
D1: Power; LED_D3.0mm
D2: WiFi; LED_D3.0mm
D3: BUS; LED_D3.0mm
D4: PESD5V0S1BA; D_SOD-323
F1: 20V/2A; Fuse_1206_3216Metric
H1, H2, H3, H4: MountingHole; MountingHole_3.2mm_M3
J1, J2: RGB_LED; PinHeader_1x03_P2.54mm_Vertical
J3: Commodore IEC; Commodore_IEC; MPN 0105 06
J4: Meatloaf IEC; Commodore_IEC; MPN 0105 06
J5: 503398-1892; MOLEX_503398-1892; PARTREV 0; LCSC Part # C428492
P1: USB_C_Plug_USB2.0; USB_C_Receptacle_GCT_USB4125-xx-x_6P_TopMnt_Horizontal; JLCPCB Part# C309366
P4: W5500 Ethernet Modul; W5500 Ethernet Modul 12pin
Q1, Q2, Q3, Q4: BC847BS; SOT-363_SC-70-6
R1, R2: 5k1; R_0603_1608Metric
R3, R5: 2k2; R_0402_1005Metric
R4, R6, R11, R13, R15, R16, R17, R18, R20, R21: 10k; R_0402_1005Metric
R7, R8, R9: 470; R_Axial_DIN0207_L6.3mm_D2.5mm_P10.16mm_Horizontal
R10, R12, R14, R19: 1k5; R_0402_1005Metric
R22: 1k; R_0402_1005Metric
SW1: Root; SW_Tactile_SPST_Angled_PTS645Vx39-2LFS
U1: ESP32-S3-DevKitC; ESP32-S3-DevKitC-1
U2: 74LVC541A; TSSOP-20_4.4x6.5mm_P0.65mm; LCSC Part# C53552927

Connections:
+3.3V: C1.1, C2.1, C3.1, J5.4 (VDD), P4.8 (3.3V), P4.9 (3.3V), R7.2, R8.2, R9.2, R16.1, R17.1, R18.1, U1.1 (3V3), U1.2 (3V3), U2.20 (VCC)
+5V: D4.2 (A2), F1.1, P1.A9 (VBUS), P1.B9 (VBUS), U1.21 (5V)
/+5V_fused: F1.2, J1.2, J2.2, R21.1, R22.1
/C64_ATN: J3.3, J4.3, Q3.6 (C1), U2.2 (A0)
/C64_CLK: J3.4, J4.4, Q2.6 (C1), U2.3 (A1)
/C64_DATA: J3.5, J4.5, Q2.3 (C2), U2.4 (A2)
/C64_RST: J3.6, J4.6, Q1.6 (C1), U2.6 (A4)
/C64_SRQ: J3.1, J4.1, Q1.3 (C2), U2.5 (A3)
/CD: J5.10 (DETECT_SWITCH), R18.2, U1.13 (GPIO3/ADC1_CH2)
/CS: J5.2 (CD/DAT3^2), R17.2, U1.20 (GPIO14/ADC2_CH3)
/INT: P4.6 (INT), U1.15 (GPIO9/ADC1_CH8)
/MISO: J5.7 (DAT0), R16.2, U1.19 (GPIO13/ADC2_CH2)
/MISO_3: P4.12 (MISO), U1.37 (GPIO40/MTDO)
/MOSI: J5.3 (CMD), U1.17 (GPIO11/ADC2_CH0)
/MOSI_3: P4.3 (MOSI), U1.38 (GPIO41/MTDI)
/M_ATN_IN: U1.4 (GPIO4/ADC1_CH3), U2.18 (Y0)
/M_ATN_OUT: R14.2, U1.8 (GPIO15/ADC2_CH4/32K_P)
/M_CLK_IN: U1.5 (GPIO5/ADC1_CH4), U2.17 (Y1)
/M_CLK_OUT: R12.2, U1.10 (GPIO17/ADC2_CH6)
/M_DATA_IN: U1.6 (GPIO6/ADC1_CH5), U2.16 (Y2)
/M_DATA_OUT: R10.2, U1.9 (GPIO16/ADC2_CH5/32K_N)
/M_RST_IN: U1.12 (GPIO8/ADC1_CH7), U2.14 (Y4)
/M_RST_OUT: R5.2, U1.14 (GPIO46)
/M_SRQ_IN: U1.7 (GPIO7/ADC1_CH6), U2.15 (Y3)
/M_SRQ_OUT: R3.2, U1.11 (GPIO18/ADC2_CH7)
/RGB_LED: R19.2, U1.29 (GPIO48)
/RGB_LED_5V: J1.1, J2.1, Q4.3 (C2), R22.2
/SCK: J5.5 (CLK), U1.18 (GPIO12/ADC2_CH1)
/SCK_3: P4.4 (SCLK), U1.36 (GPIO39/MTCK)
/SCS: P4.5 (CS), U1.16 (GPIO10/ADC1_CH9)
GND: C1.2, C2.2, C3.2, D1.1 (K), D4.1 (A1), J1.3, J2.3, J3.2, J3.7, J3.8, J4.2, J4.7, J4.8, J5.6 (VSS), J5.9 (VSS__1), J5.P1 (SHIELD), J5.P2 (SHIELD__1), J5.P3 (SHIELD__2), J5.P4 (SHIELD__3), P1.A12 (GND), P1.B12 (GND), P1.SH (SHIELD), P4.1 (GND), P4.2 (GND), P4.7 (GND), Q1.1 (E1), Q1.4 (E2), Q2.1 (E1), Q2.4 (E2), Q3.1 (E1), Q4.1 (E1), Q4.4 (E2), R1.2, R2.2, R4.2, R6.2, R11.2, R13.2, R15.2, R20.2, SW1.2, U1.22 (GND), U1.23 (GND), U1.24 (GND), U1.44 (GND), U2.1 (~OE1), U2.7 (A5), U2.8 (A6), U2.9 (A7), U2.10 (GND), U2.19 (~OE2)
unnamed: D1.2 (A), R7.1
unnamed: D2.2 (A), R8.1
unnamed: D2.1 (K), U1.41 (GPIO1/ADC1_CH0)
unnamed: D3.2 (A), R9.1
unnamed: D3.1 (K), U1.40 (GPIO2/ADC1_CH1)
unnamed: P1.A5 (CC1), R1.1
unnamed: P1.B5 (CC2), R2.1
unnamed: Q1.2 (B1), R5.1, R6.1
unnamed: Q1.5 (B2), R3.1, R4.1
unnamed: Q2.2 (B1), R12.1, R13.1
unnamed: Q2.5 (B2), R10.1, R11.1
unnamed: Q3.2 (B1), R14.1, R15.1
unnamed: Q4.2 (B1), R19.1, R20.1
unnamed: Q4.5 (B2), Q4.6 (C1), R21.2
unnamed: SW1.1, U1.31 (GPIO0)

Notes on the sheet:
half BC847BS
CLK OUT
RST OUT
3.3V kompatibel
5V/0V zum C64
ATN OUT
IEC-Input
DATA OUT
To other Devices on the IEC-bus
SRQ OUT

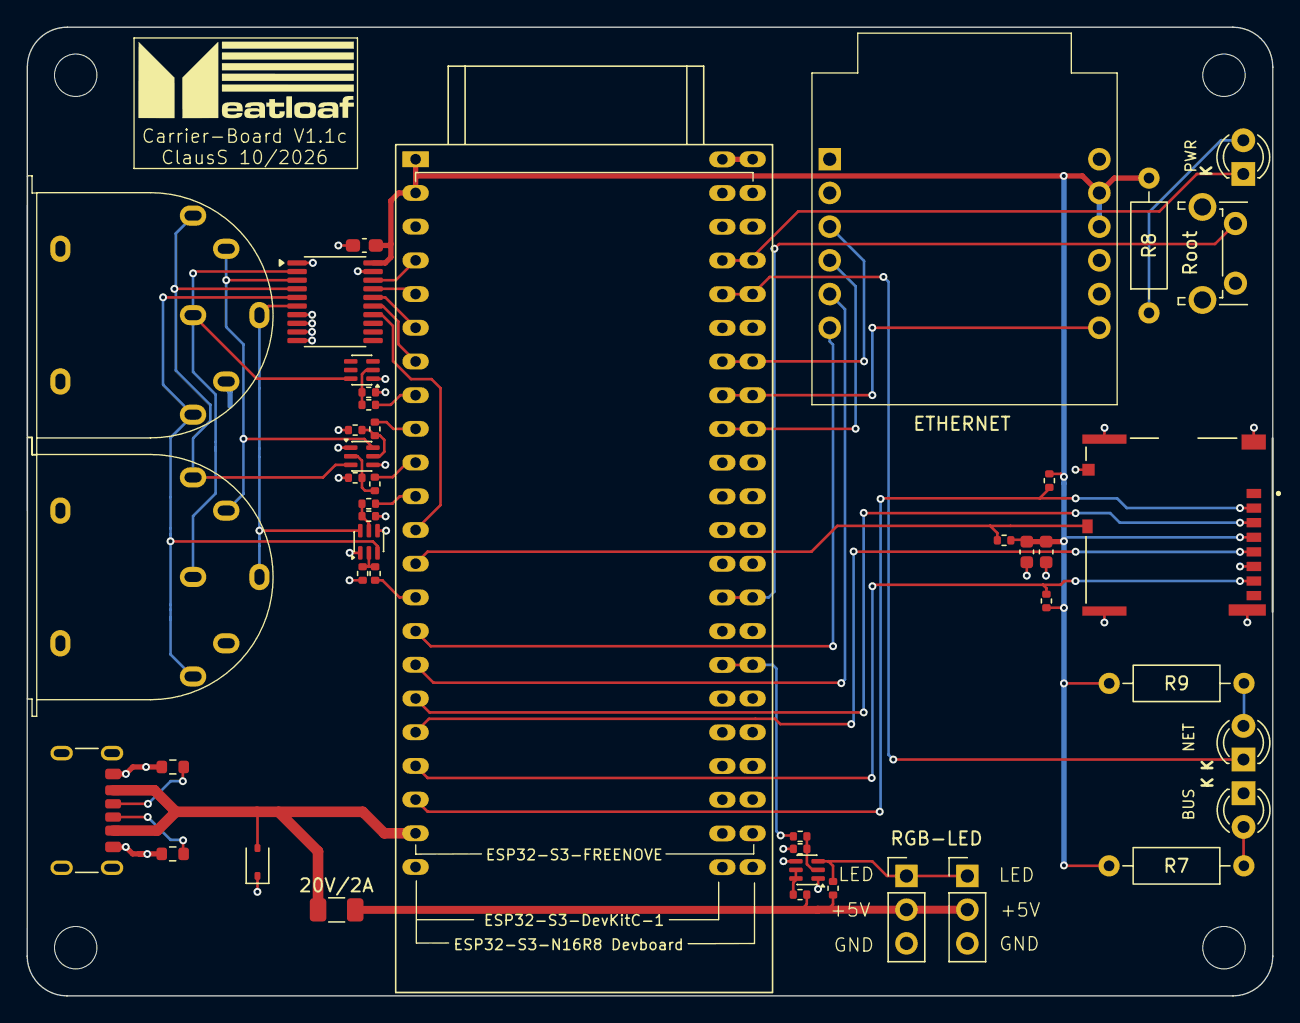
[picture p24: board Hardware/PCB-v1.1c/KiCad/Meatloaf.kicad_pcb from above]

Board: 2 copper layers, 93.9 x 73.0 mm, 48 parts (0 on the bottom side), 46 nets.
