LeshanDaFo/MeatLoaf-Hardware-ClausS/Hardware/PCB-v1.1b/KiCad/Meatloaf.kicad_pcb

## KiCad design Hardware/PCB-v1.1b/KiCad/Meatloaf.kicad_pcb (2026-11-14)

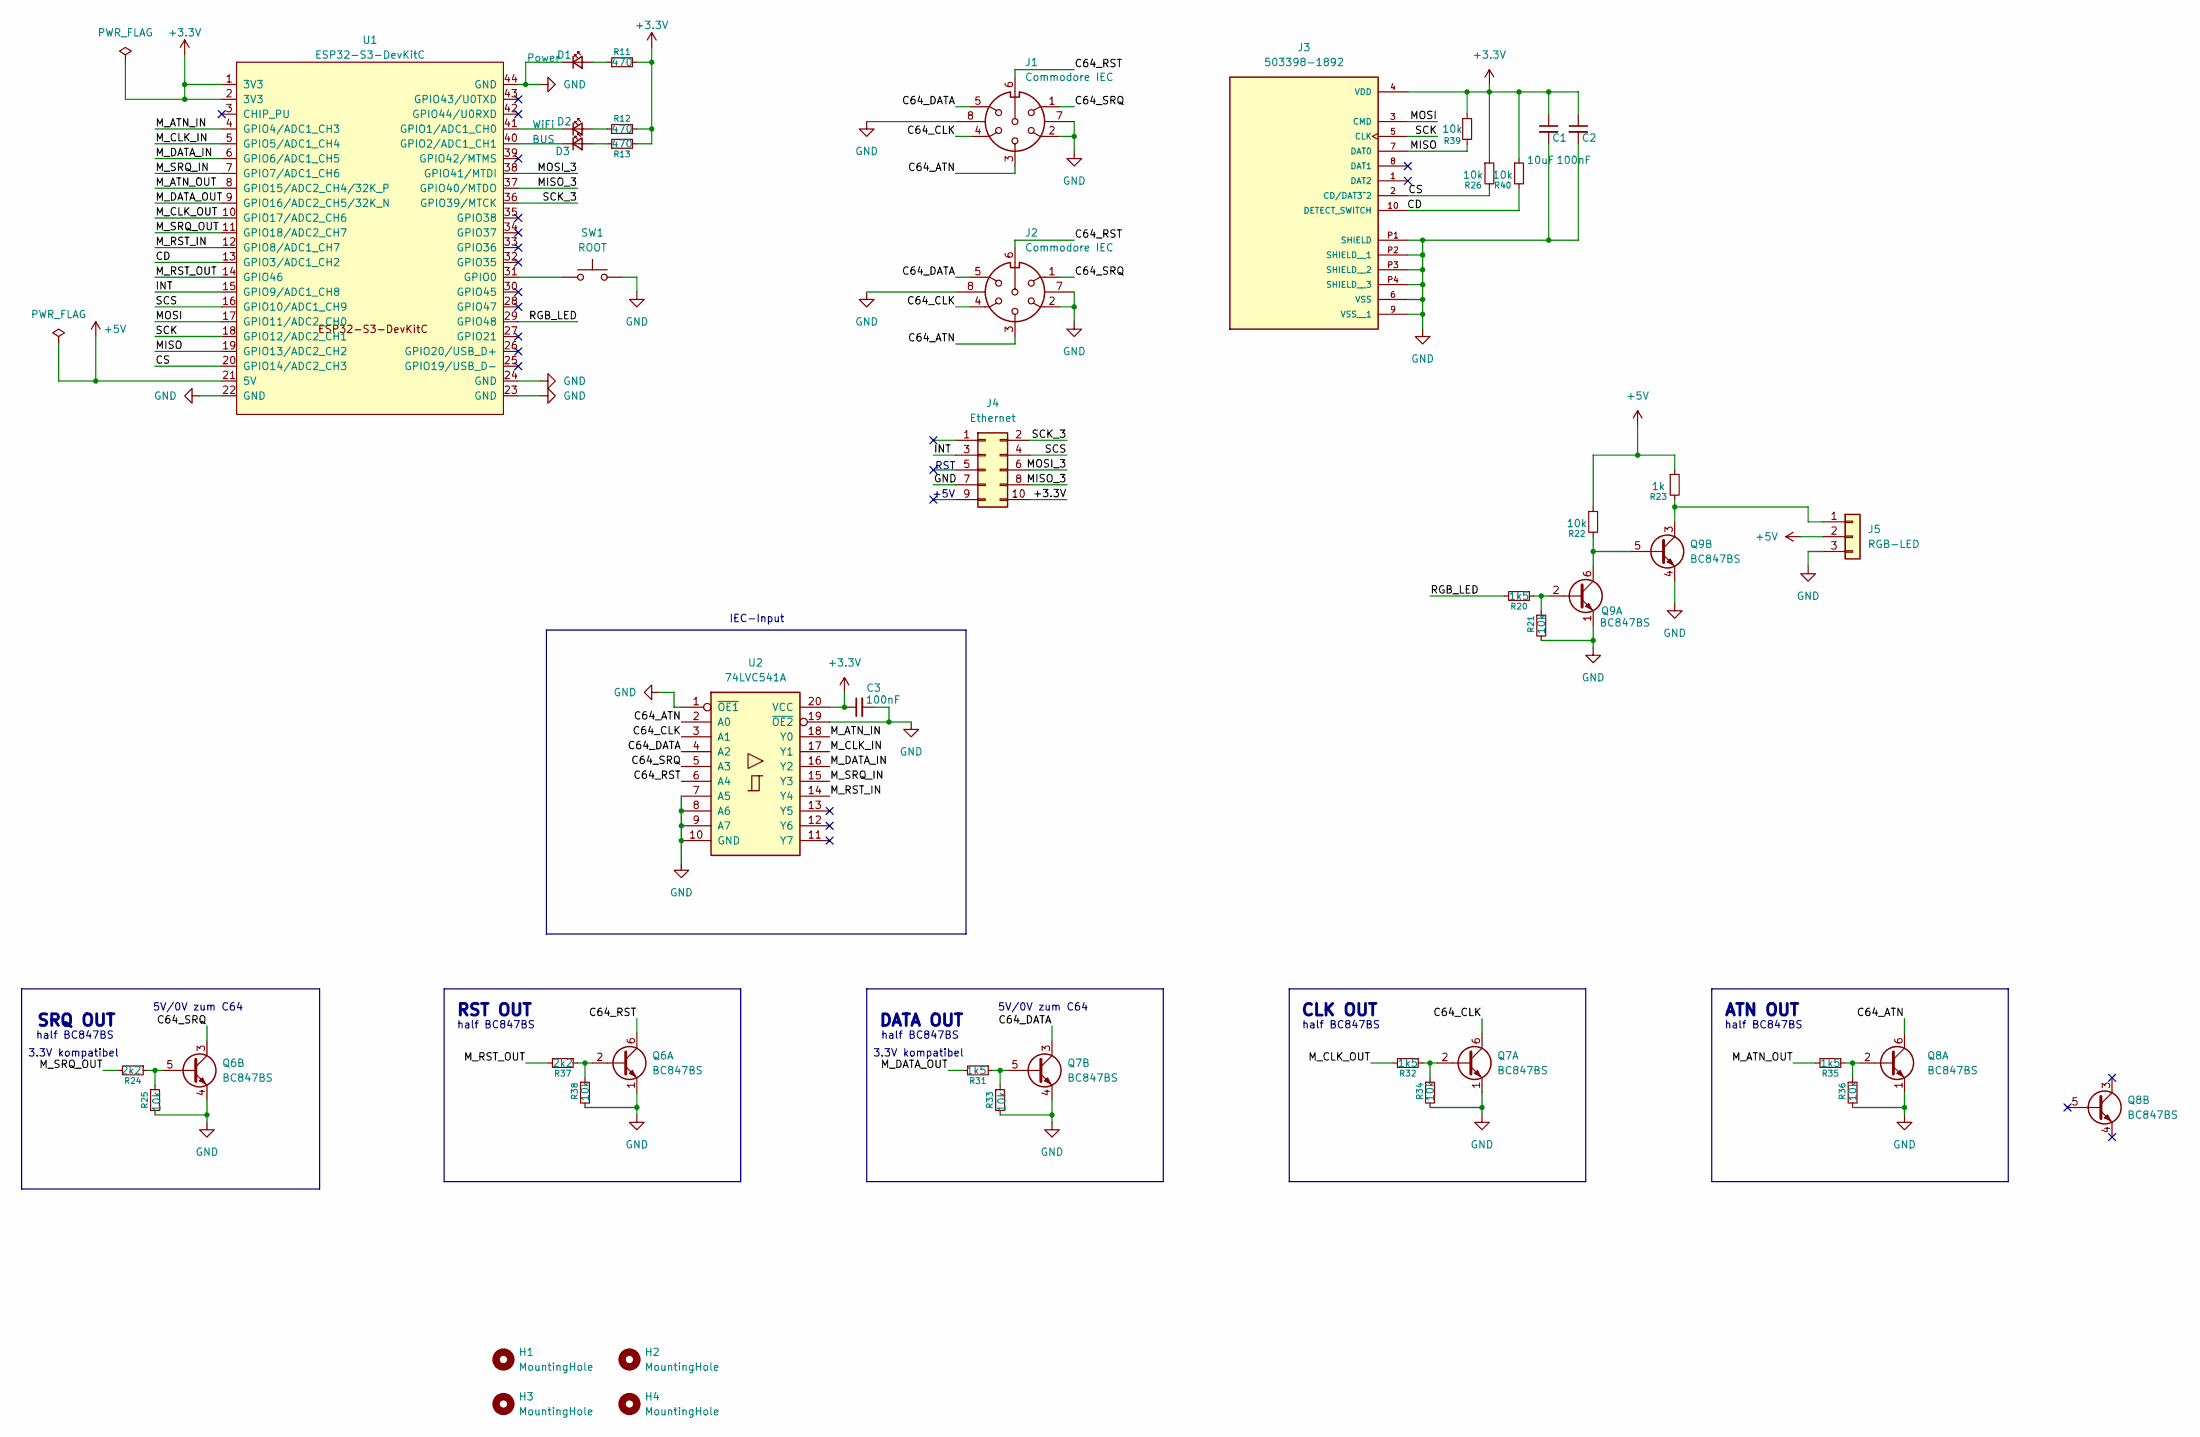
[picture p25: schematic Meatloaf.kicad_sch, Meatloaf Carrier Board]

Parts:
C1: 10uF; C_0603_1608Metric
C2: 100nF; C_0603_1608Metric
C3: 100nF; C_0603_1608Metric_Pad1.08x0.95mm_HandSolder
D1: Power; LED_D3.0mm
D2: WiFi; LED_D3.0mm
D3: BUS; LED_D3.0mm
H1, H2, H3, H4: MountingHole; MountingHole_3.2mm_M3
J1, J2: Commodore IEC; Commodore_IEC; MPN 0105 06
J3: 503398-1892; MOLEX_503398-1892; PARTREV 0; LCSC Part # C428492
J4: Ethernet; PinHeader_2x05_P2.54mm_Vertical
J5: RGB-LED; PinHeader_1x03_P2.54mm_Vertical
Q6, Q7, Q8, Q9: BC847BS; SOT-363_SC-70-6
R11, R12, R13: 470; R_Axial_DIN0207_L6.3mm_D2.5mm_P10.16mm_Horizontal
R20, R31, R32, R35: 1k5; R_0402_1005Metric
R21, R22, R25, R26, R33, R34, R36, R38, R39, R40: 10k; R_0402_1005Metric
R23: 1k; R_0402_1005Metric
R24, R37: 2k2; R_0402_1005Metric
SW1: ROOT; SW_Tactile_SPST_Angled_PTS645Vx58-2LFS
U1: ESP32-S3-DevKitC; ESP32-S3-DevKitC-1
U2: 74LVC541A; TSSOP-20_4.4x6.5mm_P0.65mm; LCSC Part# C53552927

Connections:
+3.3V: C1.1, C2.1, C3.1, J3.4 (VDD), J4.10, R11.2, R12.2, R13.2, R26.1, R39.1, R40.1, U1.1 (3V3), U1.2 (3V3), U2.20 (VCC)
+5V: J5.2, R22.1, R23.1, U1.21 (5V)
/C64_ATN: J1.3, J2.3, Q8.6 (C1), U2.2 (A0)
/C64_CLK: J1.4, J2.4, Q7.6 (C1), U2.3 (A1)
/C64_DATA: J1.5, J2.5, Q7.3 (C2), U2.4 (A2)
/C64_RST: J1.6, J2.6, Q6.6 (C1), U2.6 (A4)
/C64_SRQ: J1.1, J2.1, Q6.3 (C2), U2.5 (A3)
/CD: J3.10 (DETECT_SWITCH), R40.2, U1.13 (GPIO3/ADC1_CH2)
/CS: J3.2 (CD/DAT3^2), R26.2, U1.20 (GPIO14/ADC2_CH3)
/INT: J4.3, U1.15 (GPIO9/ADC1_CH8)
/MISO: J3.7 (DAT0), R39.2, U1.19 (GPIO13/ADC2_CH2)
/MISO_3: J4.8, U1.37 (GPIO40/MTDO)
/MOSI: J3.3 (CMD), U1.17 (GPIO11/ADC2_CH0)
/MOSI_3: J4.6, U1.38 (GPIO41/MTDI)
/M_ATN_IN: U1.4 (GPIO4/ADC1_CH3), U2.18 (Y0)
/M_ATN_OUT: R35.2, U1.8 (GPIO15/ADC2_CH4/32K_P)
/M_CLK_IN: U1.5 (GPIO5/ADC1_CH4), U2.17 (Y1)
/M_CLK_OUT: R32.2, U1.10 (GPIO17/ADC2_CH6)
/M_DATA_IN: U1.6 (GPIO6/ADC1_CH5), U2.16 (Y2)
/M_DATA_OUT: R31.2, U1.9 (GPIO16/ADC2_CH5/32K_N)
/M_RST_IN: U1.12 (GPIO8/ADC1_CH7), U2.14 (Y4)
/M_RST_OUT: R37.2, U1.14 (GPIO46)
/M_SRQ_IN: U1.7 (GPIO7/ADC1_CH6), U2.15 (Y3)
/M_SRQ_OUT: R24.2, U1.11 (GPIO18/ADC2_CH7)
/RGB_LED: R20.2, U1.29 (GPIO48)
/SCK: J3.5 (CLK), U1.18 (GPIO12/ADC2_CH1)
/SCK_3: J4.2, U1.36 (GPIO39/MTCK)
/SCS: J4.4, U1.16 (GPIO10/ADC1_CH9)
GND: C1.2, C2.2, C3.2, D1.1 (K), J1.2, J1.7, J1.8, J2.2, J2.7, J2.8, J3.6 (VSS), J3.9 (VSS__1), J3.P1 (SHIELD), J3.P2 (SHIELD__1), J3.P3 (SHIELD__2), J3.P4 (SHIELD__3), J4.7, J5.3, Q6.1 (E1), Q6.4 (E2), Q7.1 (E1), Q7.4 (E2), Q8.1 (E1), Q9.1 (E1), Q9.4 (E2), R21.2, R25.2, R33.2, R34.2, R36.2, R38.2, SW1.2, U1.22 (GND), U1.23 (GND), U1.24 (GND), U1.44 (GND), U2.1 (~OE1), U2.7 (A5), U2.8 (A6), U2.9 (A7), U2.10 (GND), U2.19 (~OE2)
unnamed: D1.2 (A), R11.1
unnamed: D2.2 (A), R12.1
unnamed: D2.1 (K), U1.41 (GPIO1/ADC1_CH0)
unnamed: D3.2 (A), R13.1
unnamed: D3.1 (K), U1.40 (GPIO2/ADC1_CH1)
unnamed: J5.1, Q9.3 (C2), R23.2
unnamed: Q6.2 (B1), R37.1, R38.1
unnamed: Q6.5 (B2), R24.1, R25.1
unnamed: Q7.2 (B1), R32.1, R34.1
unnamed: Q7.5 (B2), R31.1, R33.1
unnamed: Q8.2 (B1), R35.1, R36.1
unnamed: Q9.2 (B1), R20.1, R21.1
unnamed: Q9.5 (B2), Q9.6 (C1), R22.2
unnamed: SW1.1, U1.31 (GPIO0)

Notes on the sheet:
half BC847BS
3.3V kompatibel
DATA OUT
5V/0V zum C64
RST OUT
ATN OUT
SRQ OUT
IEC-Input
CLK OUT
RST
+5V

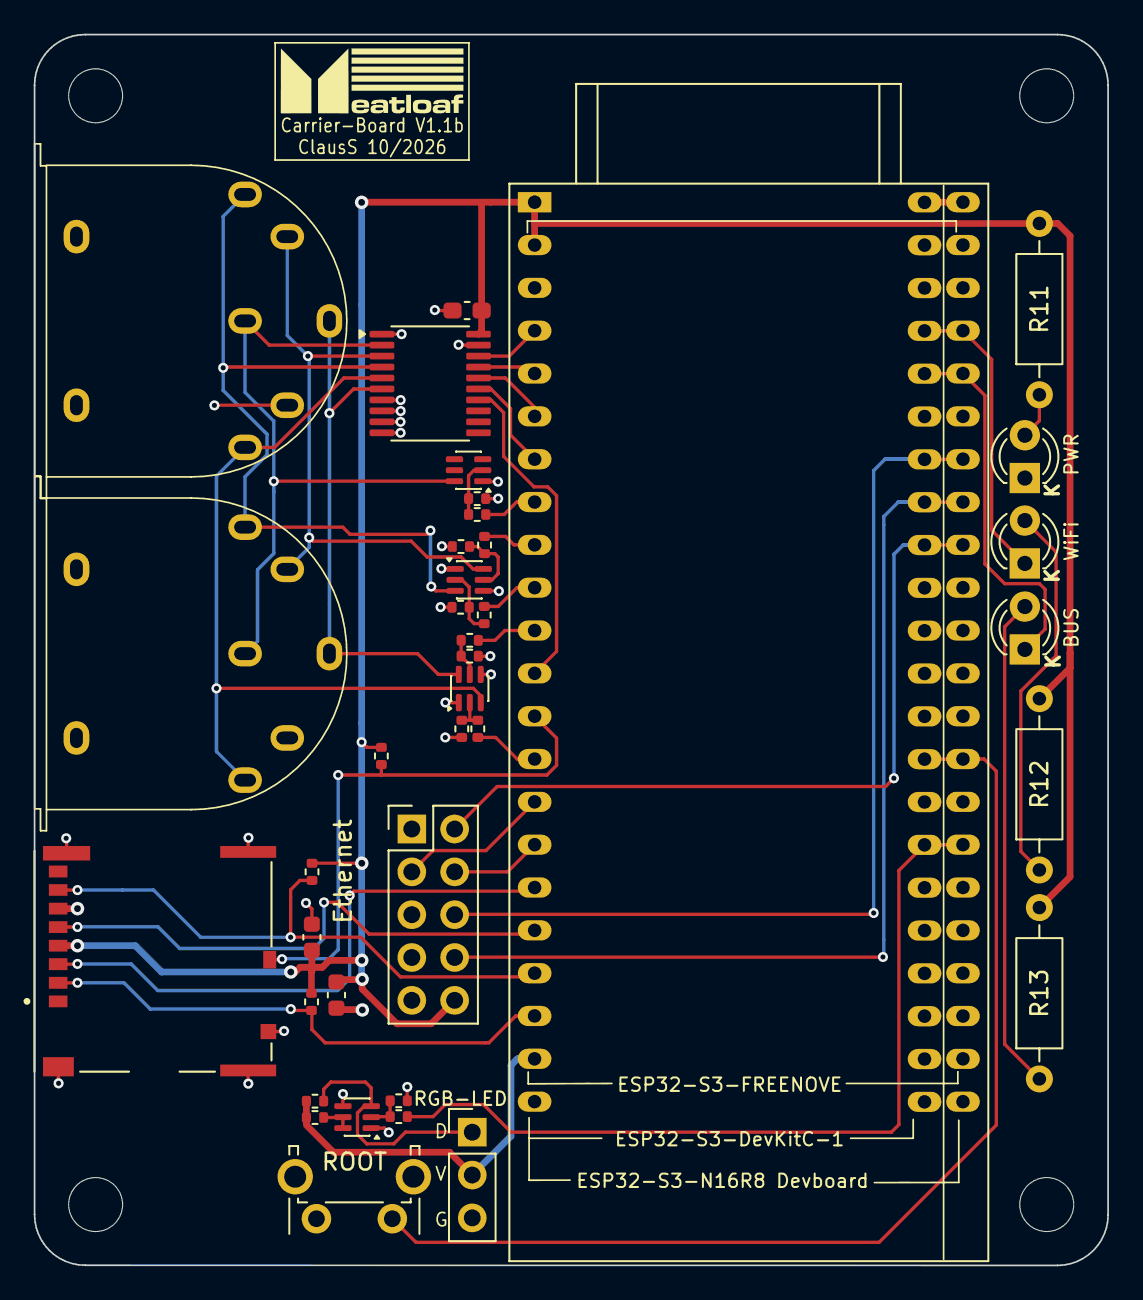
[picture p26: board Hardware/PCB-v1.1b/KiCad/Meatloaf.kicad_pcb from above]

Board: 2 copper layers, 63.7 x 73.0 mm, 42 parts (0 on the bottom side), 43 nets.
