LeshanDaFo/MeatLoaf-Hardware-ClausS/(commit log)

2026-10-28 release: update PCB v1.0 firmware with SD CRC fix
2026-11-12 Publish MeatLoaf Carrier PCB v1.1 hardware
2026-11-13 Show Commodore IEC connectors in PCB renders
2026-11-13 Show top and IEC views together for each v1.1 board
2026-11-14 Add Meatloaf branding to the carrier board README
2026-11-14 Update PCB v1.1 fabrication files and board views
2026-11-14 Update PCB v1.1a STEP assembly with silkscreen
2026-11-14 Update PCB v1.0 silkscreen and fabrication files
